duvohuu/Transmission_System_Project/Latex/main.tex

\documentclass[12pt,a4paper]{report}
\input{library}
\addbibresource{references.bib} 

%Header
\fancyhead{} % clear all header fields
\fancyhead[L]{
 \begin{tabular}{rl}
    \begin{picture}(25,15)(0,0)
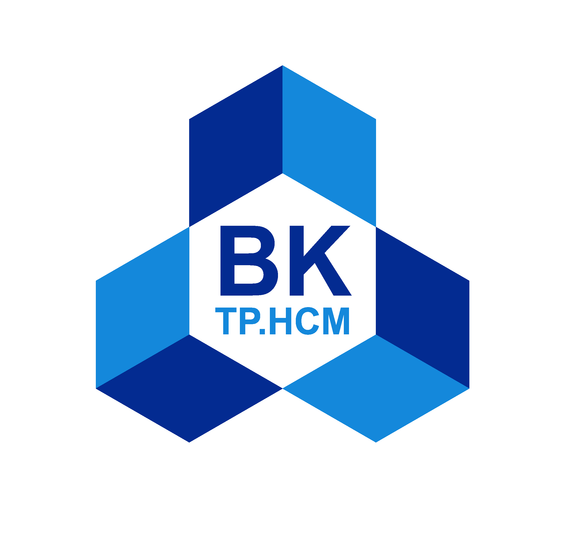
[picture p1: Latex/pictures/hcmut.png]
    \put(0,-8){}
    %\put(0,-8){\epsfig{width=10mm,figure=hcmut.eps}}
   \end{picture}&
	%\includegraphics[width=8mm, height=8mm]{hcmut.png} & %
	\begin{tabular}{l}
		\textbf{\bf \ttfamily Trường Đại Học Bách Khoa - ĐHQG TP.Hồ Chí Minh}\\
		\textbf{\bf \ttfamily Khoa Cơ Khí}\\
	\end{tabular} 	
 \end{tabular}
}
\fancyhead[R]{
	{\tiny \bf \quad} % Khoảng trắng nhỏ trong header bên phải
}

%Footer
\fancyfoot{} % clear all footer fields
\fancyfoot[L]{\scriptsize \ttfamily Đồ án Hệ thống truyền động}
\fancyfoot[R]{\scriptsize \ttfamily Trang {\thepage}/70}
\renewcommand{\headrulewidth}{0.3pt}
\renewcommand{\footrulewidth}{0.3pt}

\begin{document}
    \include{titlepage}
    \tableofcontents  
    \listoftables
    \listoffigures
    \newpage
    \Huge 
    \begin{center}
        \textbf{ĐỀ BÀI}
    \end{center}
    \normalsize
        \begin{figure}[H]
            \centering
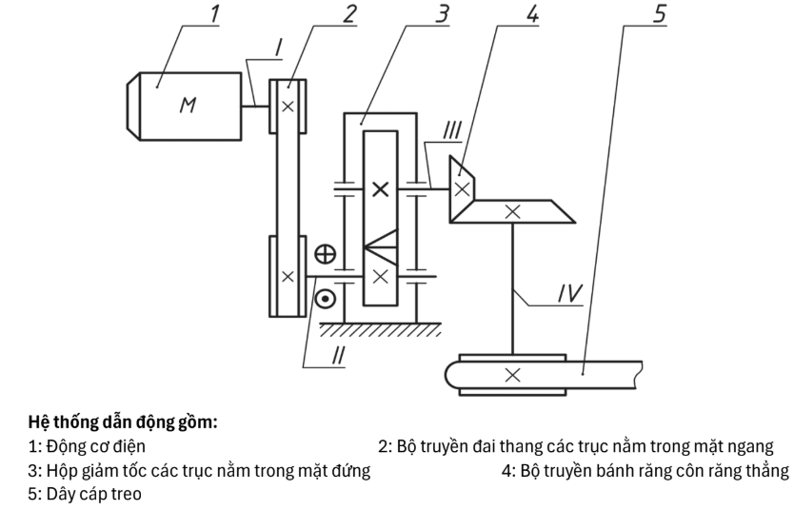
[picture p2: Latex/pictures/topic.png]
            
        \end{figure}
        \begin{center}
            \begin{tabular}{|>{\centering\arraybackslash}m{8cm}|>{\centering\arraybackslash}m{5cm}|}
                \hline
                \textbf{Phương án} & \textbf{2}  \\
                \hline
                Công suất trục cáp, P (kW) & 2.5 \\
                \hline
                Số vòng quay trục cáp, n (vòng/phút) & 12 \\
                \hline
                Thời gian phục vụ, L (năm) & 5 \\
                \hline 
            \end{tabular}\\
            Quay một chiều, làm việc hai ca (1 năm làm việc 300 ngày, 1 ca làm việc 8 giờ)
        \end{center}
        \include{chapter0}
        \include{chapter1}
        \include{chapter2}
        \include{chapter3}
        \include{chapter4}
        \include{chapter5}
        \include{chapter6}
        \include{chapter7}
        \include{chapter8}
        \nocite{*}
        \printbibliography[title={TÀI LIỆU THAM KHẢO}, heading=bibintoc]
\end{document}
