duvohuu/Transmission_System_Project/Latex/titlepage.tex

\begin{titlepage}   
    \begin{center}
        \vspace*{-2cm} 
        \large
        \textbf{ĐẠI HỌC QUỐC GIA THÀNH PHỐ HỒ CHÍ MINH \\
        TRƯỜNG ĐẠI HỌC BÁCH KHOA\\
        KHOA CƠ KHÍ\\}
        \vspace{0.5cm}
         \\
        \rule{\linewidth}{0.5mm}\\
        \vspace{1cm}
        \LARGE
        \textbf{ĐỒ ÁN}\\                                                                                                                                                                                                                    
        \vspace*{0.5cm}
        \Huge
        \textbf{HỆ THỐNG TRUYỀN ĐỘNG}\\                                                                                                                                                                                                                                                                                                                                                                                                                                             
        \vspace{0.5cm}
        \rule{\linewidth}{0.5mm}\\
        \vspace{0.6cm}
        \LARGE
        \textbf{LỚP TN01 - HK 242} \\
        \vspace{0.8cm}
        \large
        \textbf{GVHD: TS. PHẠM MINH TUẤN} \\[0.5cm]
        \vspace{0.5cm}
        SINH VIÊN THỰC HIỆN:\\[0.3cm]
        \begin{tabular}{|>{\centering\arraybackslash}m{1cm}|>{\centering\arraybackslash}m{7cm}|>{\centering\arraybackslash}m{5cm}|}
            \hline
            \textbf{STT} & \textbf{Họ và tên} & \textbf{MSSV} \\
            \hline
            1 & Võ Hữu Dư & 2210604 \\
            \hline
            2 & Võ Trần Trọng Khang & 2211480 \\
            \hline
        \end{tabular}
    \end{center}
        
    \vfill
    \large
    \begin{center}
        TP.HCM, \today
    \end{center}
\end{titlepage}
