duvohuu/Transmission_System_Project/Latex/pictures/elastic_shaft_connection.png

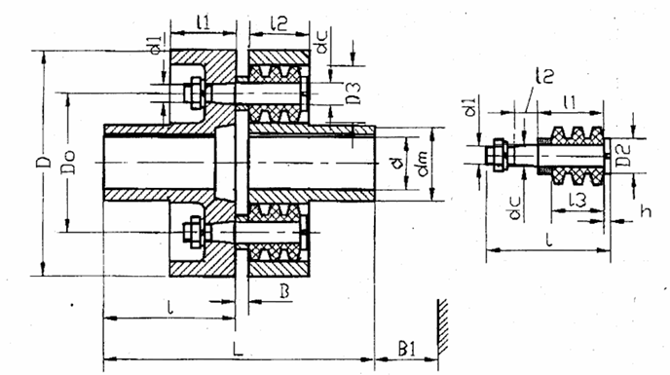
Latex/pictures/elastic_shaft_connection.png
