duvohuu/Transmission_System_Project/Latex/pictures/elastic_shaft_connection_standard.png

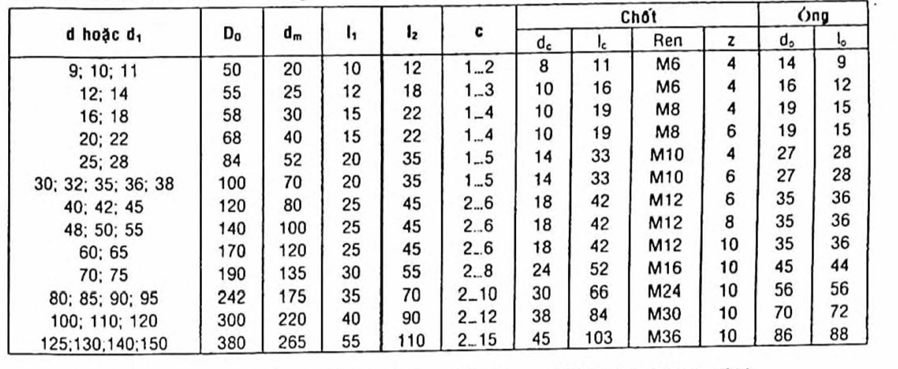
Latex/pictures/elastic_shaft_connection_standard.png
