duvohuu/Transmission_System_Project/Solidworks/10t-winch-1.snapshot.2/Winch.png

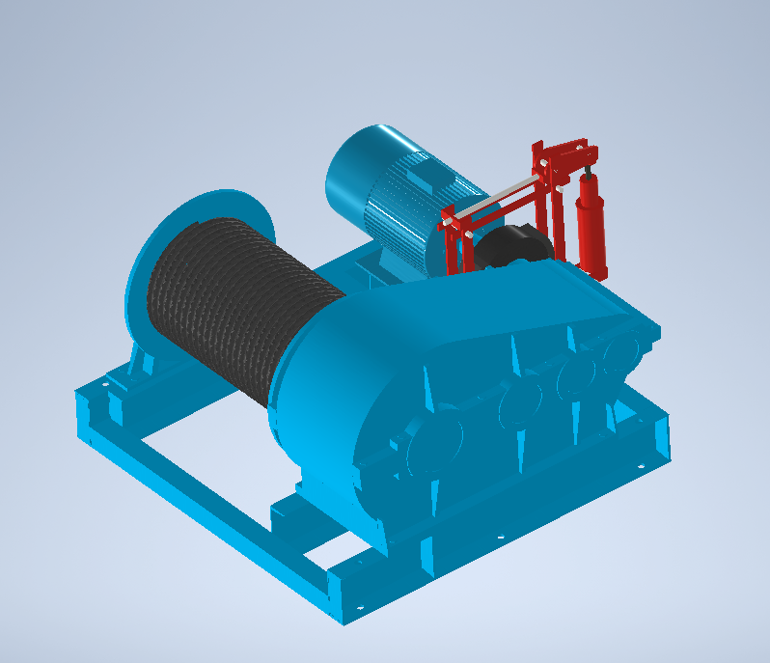
Solidworks/10t-winch-1.snapshot.2/Winch.png
