duvohuu/Transmission_System_Project/Solidworks/weg-electric-motor-132s-1.snapshot.1/Motor11.JPG

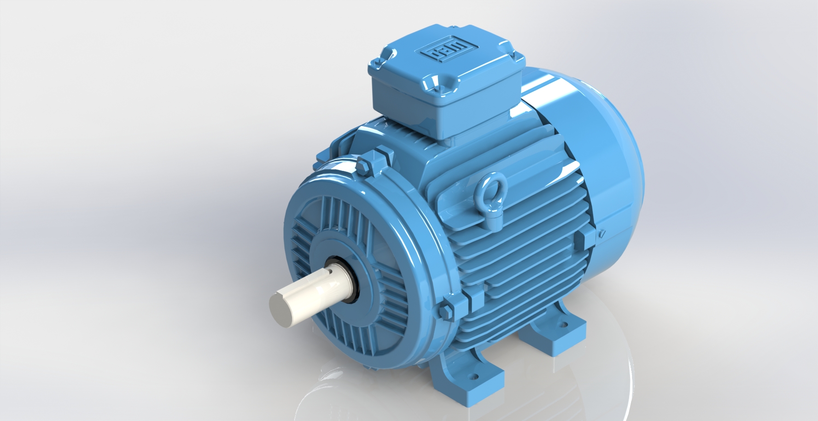
Solidworks/weg-electric-motor-132s-1.snapshot.1/Motor11.JPG
