duvohuu/Transmission_System_Project/Solidworks/10t-winch-1.snapshot.2/卷扬机三维建模.stp

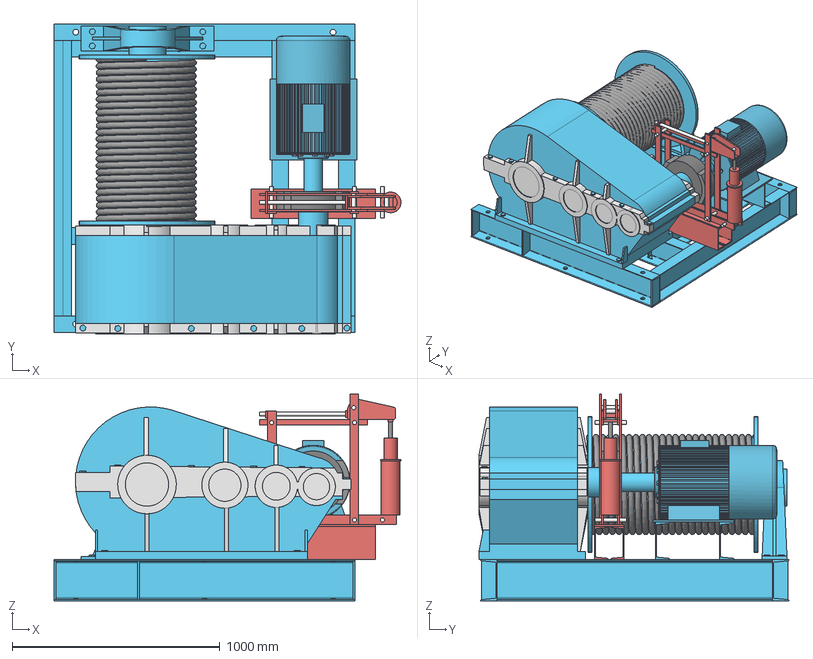
[picture p31: CAD file, 2025-05-07]
Solidworks/10t-winch-1.snapshot.2/卷扬机三维建模.stp
1672.3 x 1495.0 x 997.5 mm
卷扬机三维建模_1
卷扬机三维建模_1_1
卷扬机三维建模_2
卷扬机三维建模_3
卷扬机三维建模_4
卷扬机三维建模_5
卷扬机三维建模_6
卷扬机三维建模_7
卷扬机三维建模_8
卷扬机三维建模_9
卷扬机三维建模_10
卷扬机三维建模_11
卷扬机三维建模_12
卷扬机三维建模_13
卷扬机三维建模_14
卷扬机三维建模_15
卷扬机三维建模_16
卷扬机三维建模_17
卷扬机三维建模_18
卷扬机三维建模_19
卷扬机三维建模_20
卷扬机三维建模_21
卷扬机三维建模_22
卷扬机三维建模_23
卷扬机三维建模_24
卷扬机三维建模_25
卷扬机三维建模_26
卷扬机三维建模_27
卷扬机三维建模_28
卷扬机三维建模_29
卷扬机三维建模_30
卷扬机三维建模_31
卷扬机三维建模_32
卷扬机三维建模_33
卷扬机三维建模_34
卷扬机三维建模_35
卷扬机三维建模_36
卷扬机三维建模_37
卷扬机三维建模_38
卷扬机三维建模_39
卷扬机三维建模_40
卷扬机三维建模_41
卷扬机三维建模_42
卷扬机三维建模_43
卷扬机三维建模_44
卷扬机三维建模_45
卷扬机三维建模_46
卷扬机三维建模_47
卷扬机三维建模_48
卷扬机三维建模_49
卷扬机三维建模_50
卷扬机三维建模_51
卷扬机三维建模_52
卷扬机三维建模_53
卷扬机三维建模_54
卷扬机三维建模_55
卷扬机三维建模_56
卷扬机三维建模_57
卷扬机三维建模_58
卷扬机三维建模_59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
