duvohuu/Transmission_System_Project/Solidworks/helical-gear-box-5.snapshot.1/Helical Gearbox/11.5 Key 100x12 D12.SLDPRT

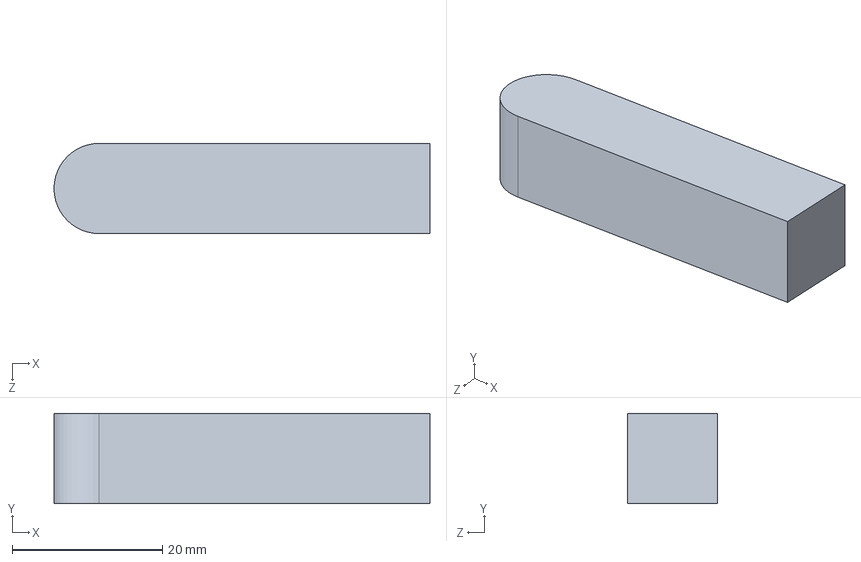
[picture p32: CAD file, 2025-05-07]
Solidworks/helical-gear-box-5.snapshot.1/Helical Gearbox/11.5 Key 100x12 D12.SLDPRT
50.0 x 12.0 x 12.0 mm
