duvohuu/Transmission_System_Project/Solidworks/helical-gear-box-5.snapshot.1/Helical Gearbox/14. Oil Probe.SLDPRT

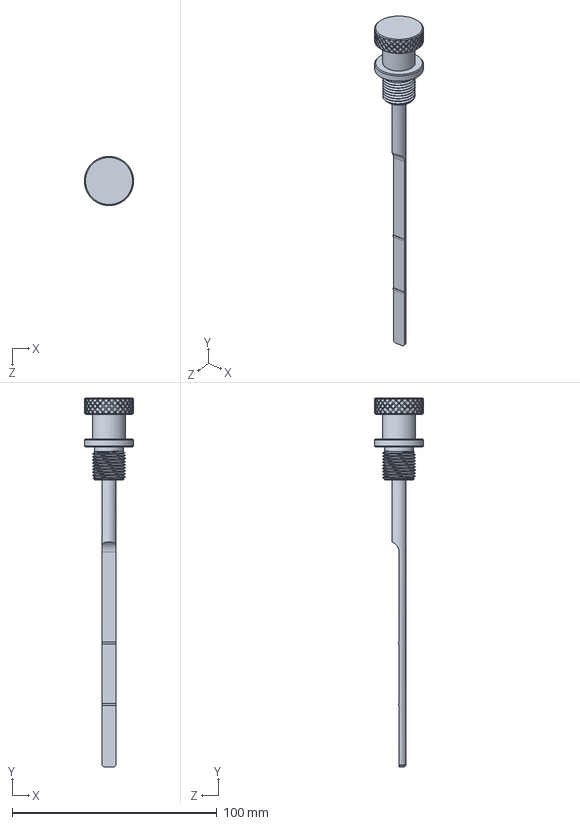
[picture p33: CAD file, 2025-05-07]
Solidworks/helical-gear-box-5.snapshot.1/Helical Gearbox/14. Oil Probe.SLDPRT
24.0 x 180.0 x 24.0 mm
