duvohuu/Transmission_System_Project/Solidworks/helical-gear-box-5.snapshot.1/Helical Gearbox/08. Ring Distance 60x25.5.SLDPRT

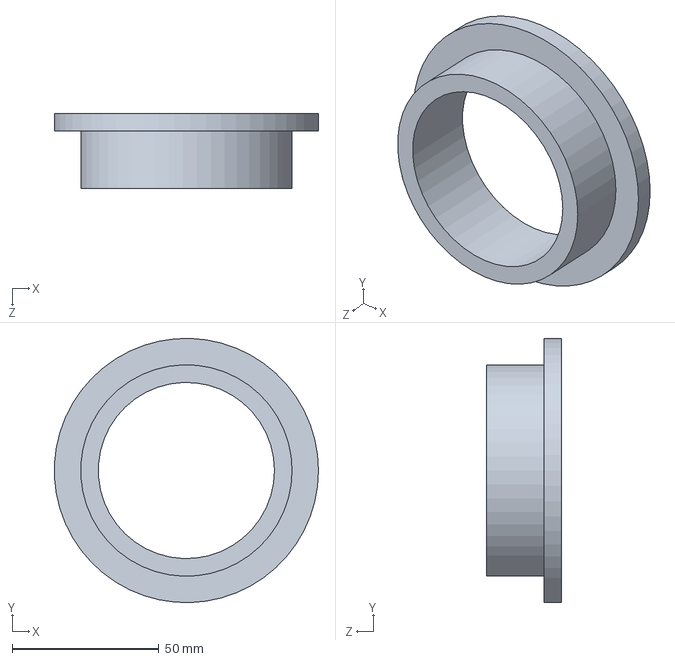
[picture p34: CAD file, 2025-05-07]
Solidworks/helical-gear-box-5.snapshot.1/Helical Gearbox/08. Ring Distance 60x25.5.SLDPRT
89.9 x 90.0 x 25.5 mm
