duvohuu/Transmission_System_Project/Solidworks/helical-gear-box-5.snapshot.1/Helical Gearbox/Gear 21.SLDPRT

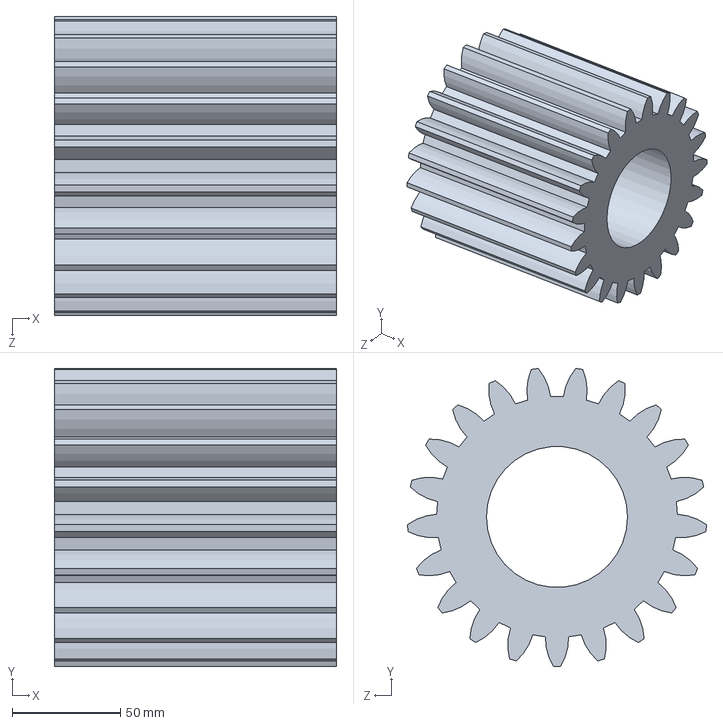
[picture p35: CAD file, 2025-05-07]
Solidworks/helical-gear-box-5.snapshot.1/Helical Gearbox/Gear 21.SLDPRT
130.0 x 137.4 x 137.8 mm
