duvohuu/Transmission_System_Project/Solidworks/helical-gear-box-5.snapshot.1/Helical Gearbox/11.3 Key 115x16 D18.SLDPRT

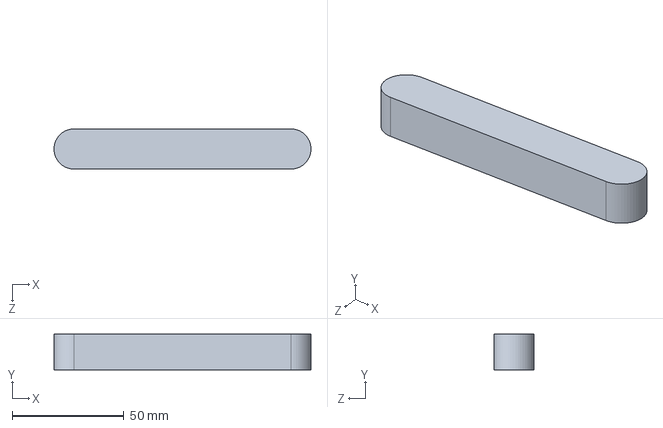
[picture p36: CAD file, 2025-05-07]
Solidworks/helical-gear-box-5.snapshot.1/Helical Gearbox/11.3 Key 115x16 D18.SLDPRT
115.0 x 16.0 x 18.0 mm
