duvohuu/Transmission_System_Project/Solidworks/helical-gear-box-5.snapshot.1/Helical Gearbox/11.1 Key 70x12 D16.SLDPRT

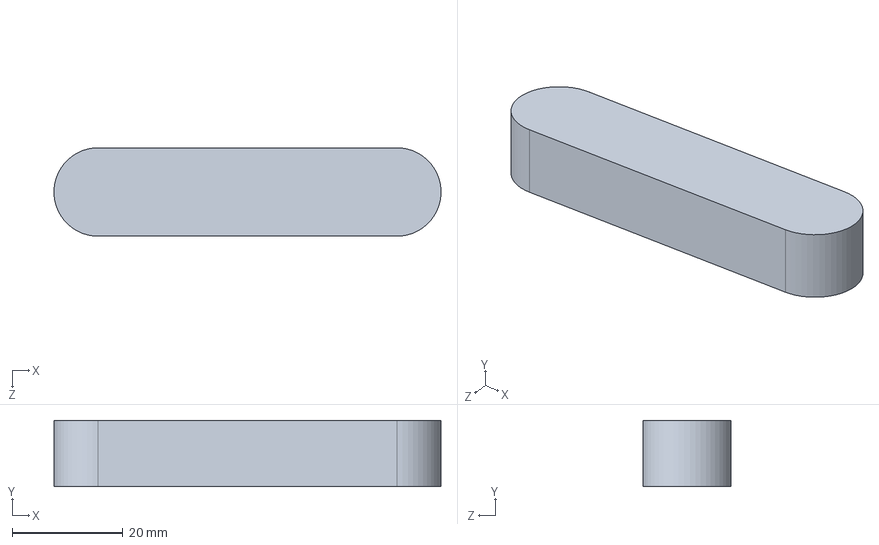
[picture p37: CAD file, 2025-05-07]
Solidworks/helical-gear-box-5.snapshot.1/Helical Gearbox/11.1 Key 70x12 D16.SLDPRT
70.0 x 12.0 x 16.0 mm
