duvohuu/Transmission_System_Project/Solidworks/helical-gear-box-5.snapshot.1/Helical Gearbox/11.2 Key 125x12 D12.SLDPRT

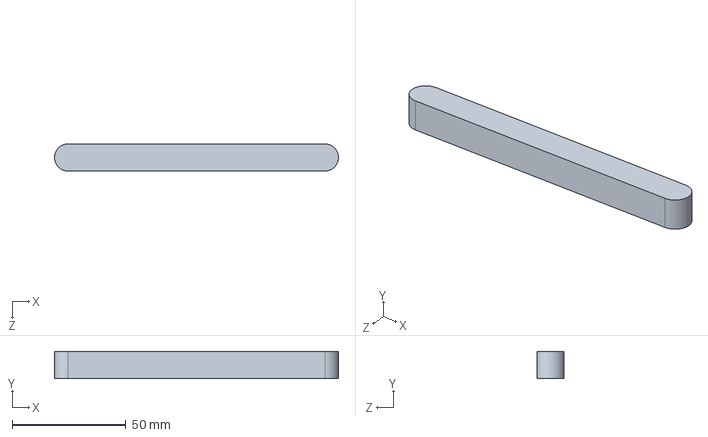
[picture p38: CAD file, 2025-05-07]
Solidworks/helical-gear-box-5.snapshot.1/Helical Gearbox/11.2 Key 125x12 D12.SLDPRT
125.0 x 12.0 x 12.0 mm
