duvohuu/Transmission_System_Project/Solidworks/helical-gear-box-5.snapshot.1/Helical Gearbox/12.Door Cover Plate.SLDPRT

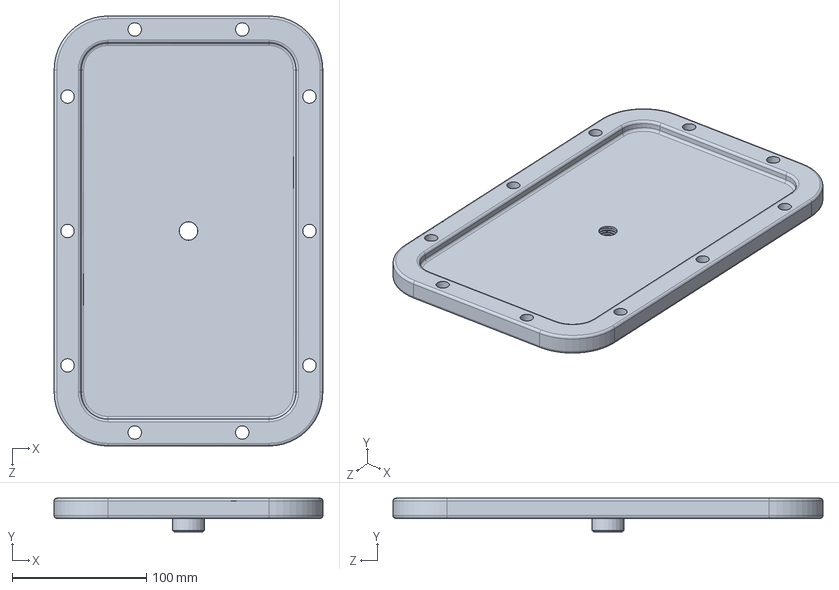
[picture p39: CAD file, 2025-05-07]
Solidworks/helical-gear-box-5.snapshot.1/Helical Gearbox/12.Door Cover Plate.SLDPRT
200.0 x 25.0 x 320.0 mm
