duvohuu/Transmission_System_Project/Solidworks/helical-gear-box-5.snapshot.1/Helical Gearbox/07. Shaft Middle.SLDPRT

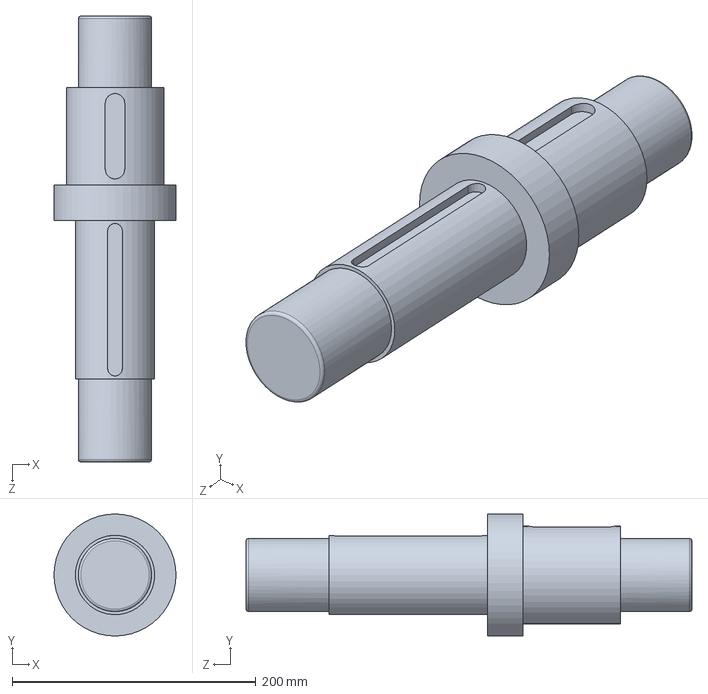
[picture p40: CAD file, 2025-05-07]
Solidworks/helical-gear-box-5.snapshot.1/Helical Gearbox/07. Shaft Middle.SLDPRT
100.0 x 100.0 x 365.5 mm
