duvohuu/Transmission_System_Project/Solidworks/helical-gear-box-5.snapshot.1/Helical Gearbox/10. Ring Distance 85x137.5.SLDPRT

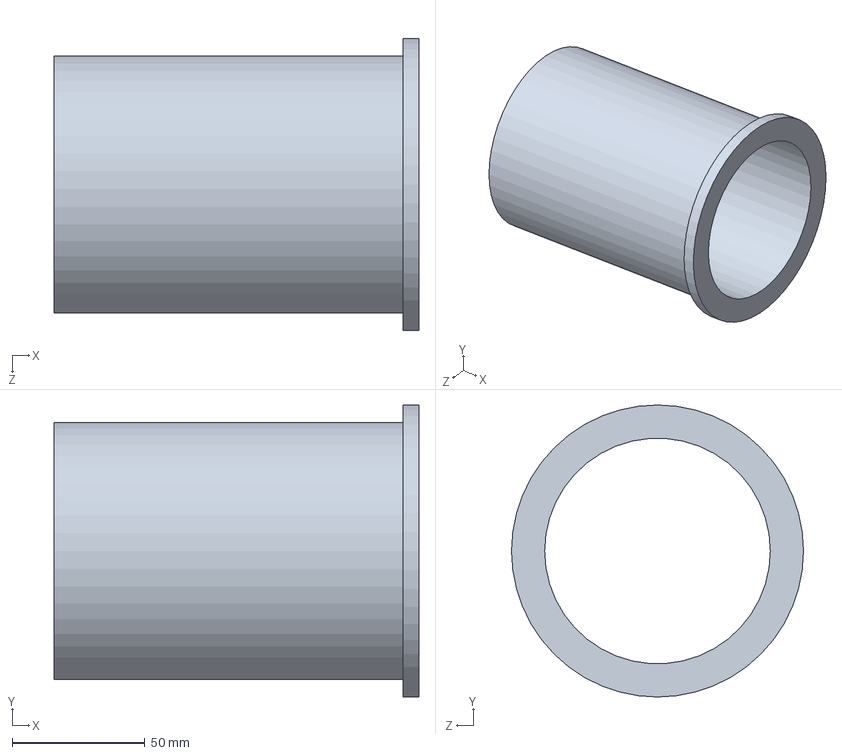
[picture p41: CAD file, 2025-05-07]
Solidworks/helical-gear-box-5.snapshot.1/Helical Gearbox/10. Ring Distance 85x137.5.SLDPRT
137.5 x 110.0 x 110.0 mm
