duvohuu/Transmission_System_Project/Solidworks/helical-gear-box-5.snapshot.1/Helical Gearbox/16. Cover Plate Bearing.SLDPRT

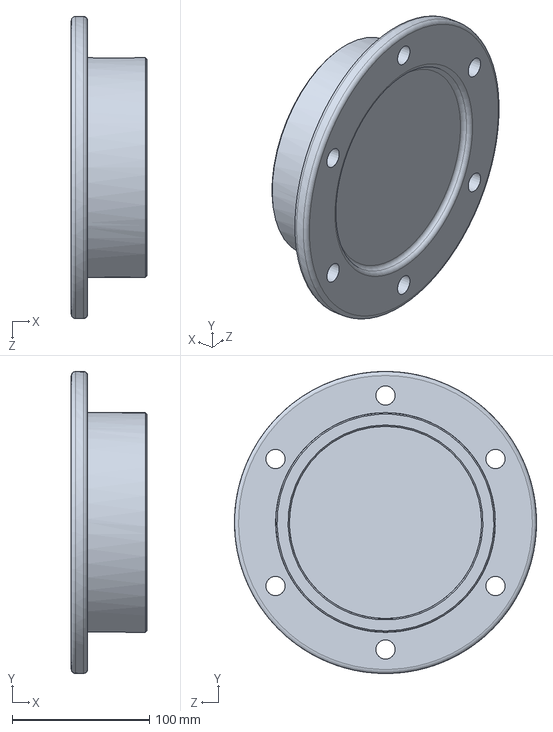
[picture p42: CAD file, 2025-05-07]
Solidworks/helical-gear-box-5.snapshot.1/Helical Gearbox/16. Cover Plate Bearing.SLDPRT
55.0 x 220.0 x 220.0 mm
