duvohuu/Transmission_System_Project/Solidworks/helical-gear-box-5.snapshot.1/Helical Gearbox/13. Blunking Plug.SLDPRT

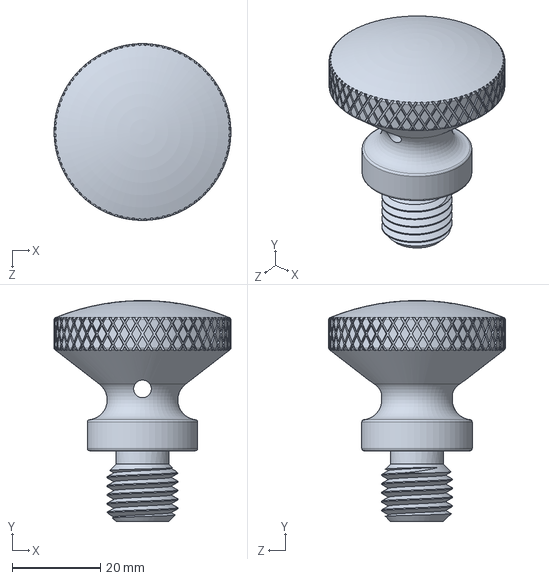
[picture p43: CAD file, 2025-05-07]
Solidworks/helical-gear-box-5.snapshot.1/Helical Gearbox/13. Blunking Plug.SLDPRT
40.0 x 50.0 x 40.0 mm
