duvohuu/Transmission_System_Project/Solidworks/helical-gear-box-5.snapshot.1/Helical Gearbox/05. Shaft Speed Gear 28.SLDPRT

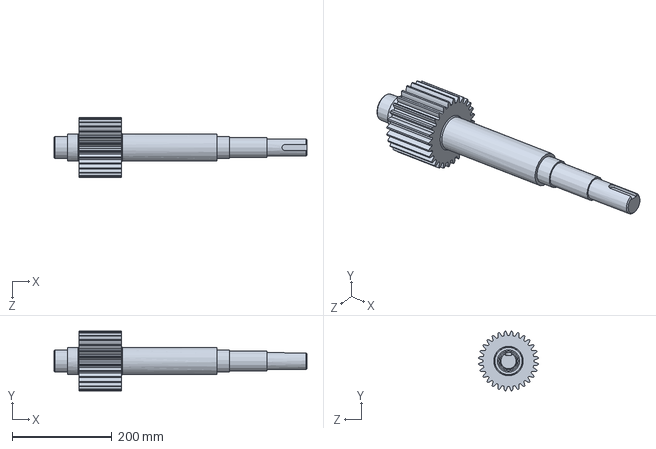
[picture p44: CAD file, 2025-05-07]
Solidworks/helical-gear-box-5.snapshot.1/Helical Gearbox/05. Shaft Speed Gear 28.SLDPRT
507.0 x 119.5 x 119.5 mm
