duvohuu/Transmission_System_Project/Solidworks/helical-gear-box-5.snapshot.1/Helical Gearbox/01. Shell.SLDPRT

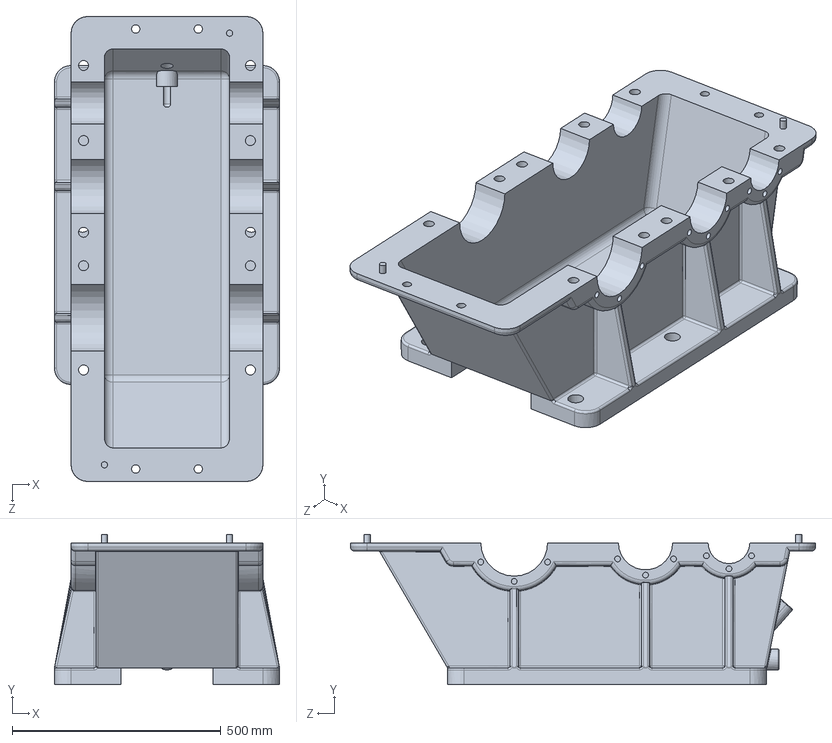
[picture p45: CAD file, 2025-05-07]
Solidworks/helical-gear-box-5.snapshot.1/Helical Gearbox/01. Shell.SLDPRT
540.0 x 360.0 x 1115.0 mm
