duvohuu/Transmission_System_Project/Solidworks/helical-gear-box-5.snapshot.1/Helical Gearbox/09. Ring Distance 60x35.SLDPRT

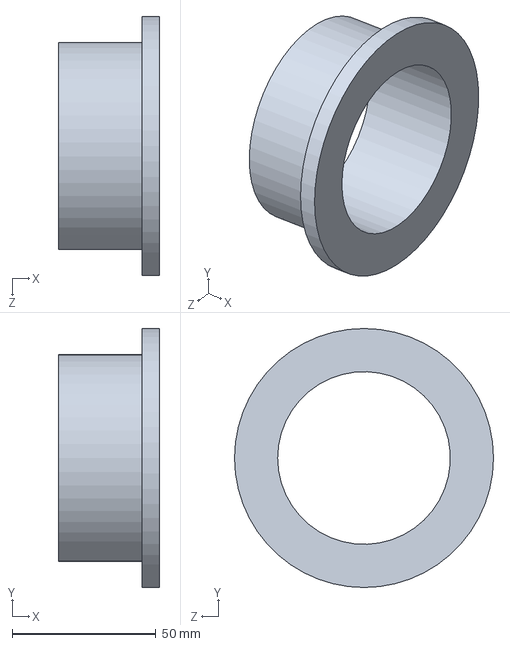
[picture p46: CAD file, 2025-05-07]
Solidworks/helical-gear-box-5.snapshot.1/Helical Gearbox/09. Ring Distance 60x35.SLDPRT
35.0 x 90.0 x 90.0 mm
