duvohuu/Transmission_System_Project/Solidworks/helical-gear-box-5.snapshot.1/Helical Gearbox/04. Gear 84.SLDPRT

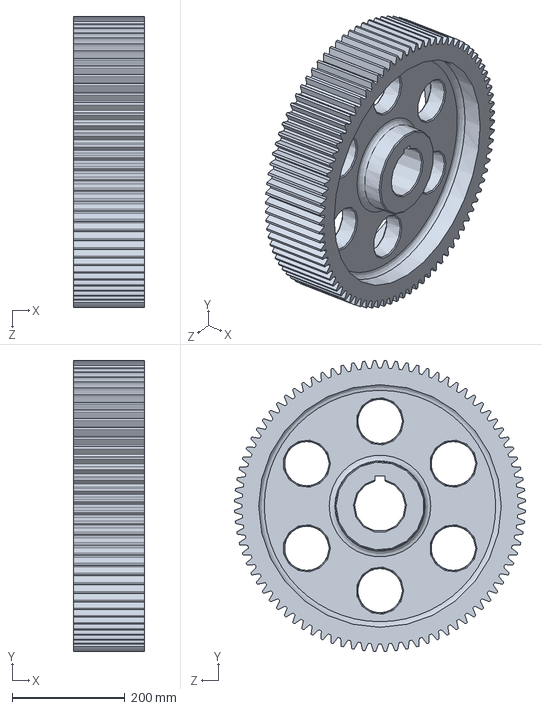
[picture p47: CAD file, 2025-05-07]
Solidworks/helical-gear-box-5.snapshot.1/Helical Gearbox/04. Gear 84.SLDPRT
125.0 x 515.8 x 515.8 mm
