duvohuu/Transmission_System_Project/Solidworks/helical-gear-box-5.snapshot.1/Helical Gearbox/03. Gear 72.SLDPRT

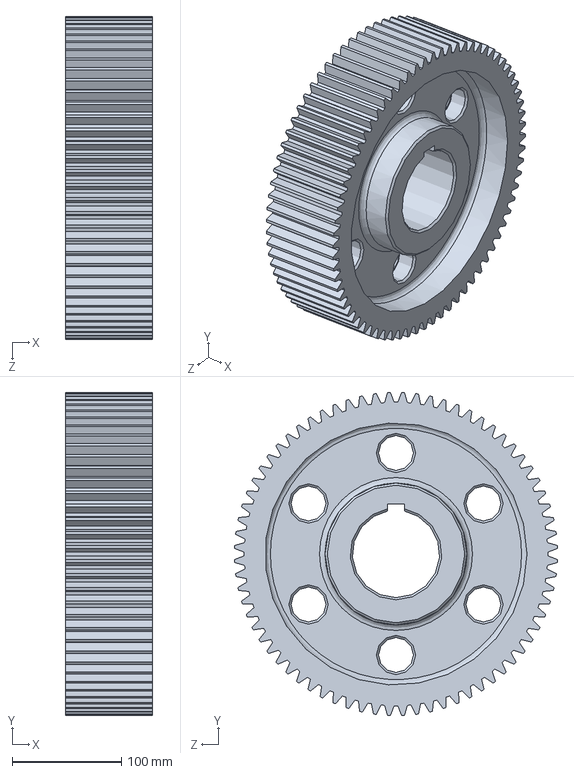
[picture p48: CAD file, 2025-05-07]
Solidworks/helical-gear-box-5.snapshot.1/Helical Gearbox/03. Gear 72.SLDPRT
80.0 x 295.8 x 295.8 mm
