duvohuu/Transmission_System_Project/Solidworks/helical-gear-box-5.snapshot.1/Helical Gearbox/11.4 Key 160x20 D20.SLDPRT

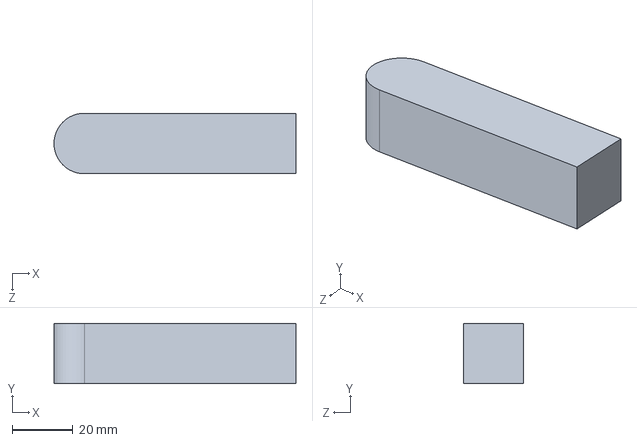
[picture p49: CAD file, 2025-05-07]
Solidworks/helical-gear-box-5.snapshot.1/Helical Gearbox/11.4 Key 160x20 D20.SLDPRT
80.0 x 20.0 x 20.0 mm
