duvohuu/Transmission_System_Project/Solidworks/helical-gear-box-5.snapshot.1/Helical Gearbox/17. Cover Plate Bearing (Hole).SLDPRT

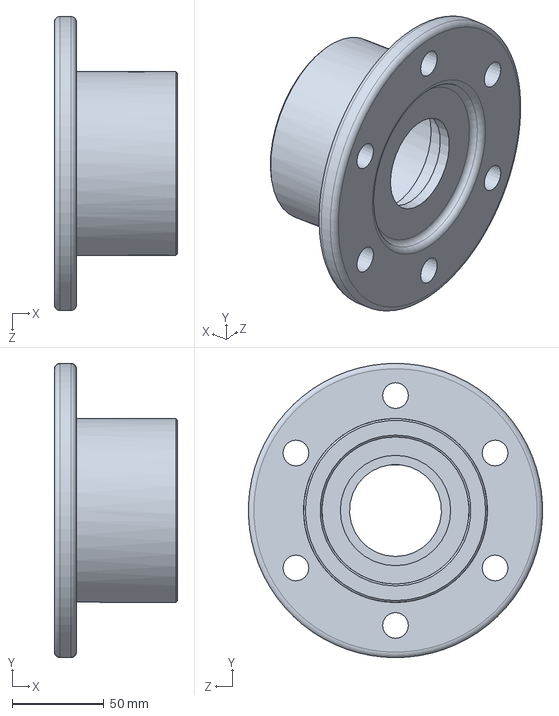
[picture p50: CAD file, 2025-05-07]
Solidworks/helical-gear-box-5.snapshot.1/Helical Gearbox/17. Cover Plate Bearing (Hole).SLDPRT
67.0 x 160.0 x 159.9 mm
