duvohuu/Transmission_System_Project/Solidworks/helical-gear-box-5.snapshot.1/Helical Gearbox/06. Shaft Slow.SLDPRT

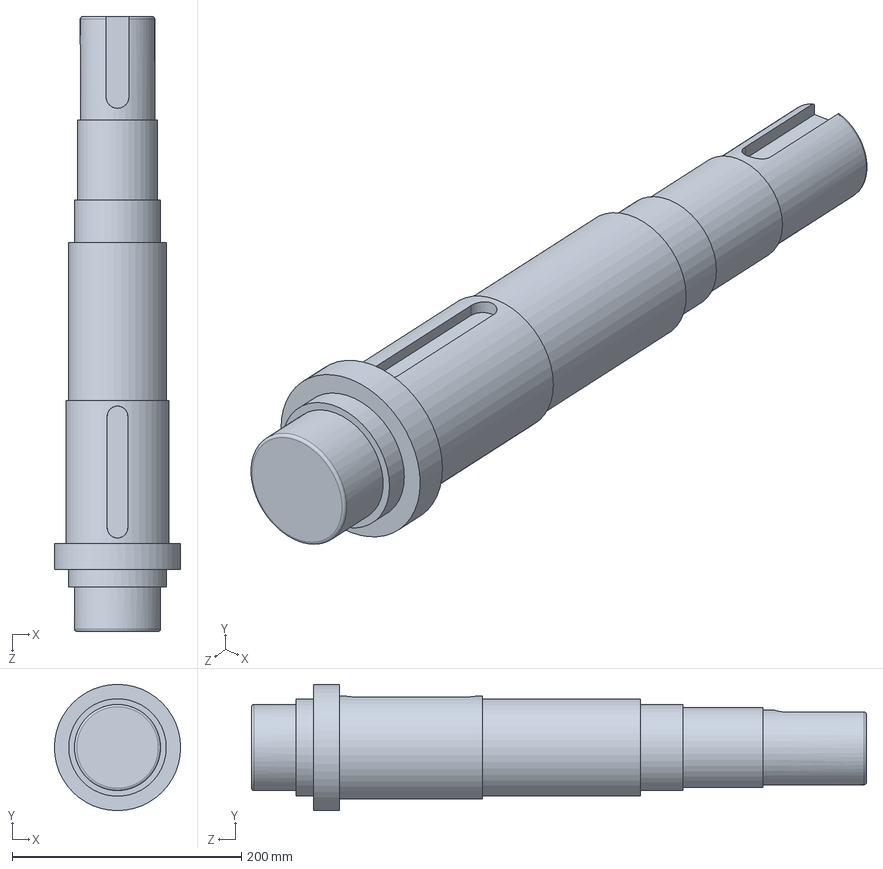
[picture p51: CAD file, 2025-05-07]
Solidworks/helical-gear-box-5.snapshot.1/Helical Gearbox/06. Shaft Slow.SLDPRT
110.0 x 110.0 x 536.0 mm
