duvohuu/Transmission_System_Project/(list of files, cad)

Other CAD files:
Cad/Helical Gearbox Assembly.DWG
Cad/GearBox.dwg
Cad/System.dwg
Cad/Detail_2.dwg
Cad/Detail_1.dwg
Cad/Banhrangcon.dwg
Cad/momen.dwg
Cad/Motor 132S.DWG
Solidworks/10t-winch-1.snapshot.2/10t Winch/--+¿+-+¦+- (4)/Design Data/AIT/Mold Design/mold design stop pin.ipt
Solidworks/10t-winch-1.snapshot.2/10t Winch/--+¿+-+¦+- (4)/Design Data/Cable & Harness/zh-CN/harness.iam
Solidworks/10t-winch-1.snapshot.2/10t Winch/--+¿+-+¦+- (4)/Design Data/Tube & Pipe/zh-CN/piping runs.iam
Solidworks/10t-winch-1.snapshot.2/10t Winch/--+¿+-+¦+- (4)/Workspaces/¦ñ+˜+++S/+f-n+·-ú--/+f-n+·+²+¼+¿-ú.iam
Solidworks/10t-winch-1.snapshot.2/10t Winch/--+¿+-+¦+- (4)/Workspaces/¦ñ+˜+++S/+f-n+·-ú--/+f-n+·+²+¼+¿-ú.ipt
Solidworks/10t-winch-1.snapshot.2/10t Winch/--+¿+-+¦+- (4)/Workspaces/¦ñ+˜+++S/+f-n+·-ú--/+f-n+·+²+¼+¿-ú_1.ipt
Solidworks/10t-winch-1.snapshot.2/10t Winch/--+¿+-+¦+- (4)/Workspaces/¦ñ+˜+++S/+f-n+·-ú--/+f-n+·+²+¼+¿-ú_10.ipt
Solidworks/10t-winch-1.snapshot.2/10t Winch/--+¿+-+¦+- (4)/Workspaces/¦ñ+˜+++S/+f-n+·-ú--/+f-n+·+²+¼+¿-ú_11.ipt
Solidworks/10t-winch-1.snapshot.2/10t Winch/--+¿+-+¦+- (4)/Workspaces/¦ñ+˜+++S/+f-n+·-ú--/+f-n+·+²+¼+¿-ú_12.ipt
Solidworks/10t-winch-1.snapshot.2/10t Winch/--+¿+-+¦+- (4)/Workspaces/¦ñ+˜+++S/+f-n+·-ú--/+f-n+·+²+¼+¿-ú_13.ipt
Solidworks/10t-winch-1.snapshot.2/10t Winch/--+¿+-+¦+- (4)/Workspaces/¦ñ+˜+++S/+f-n+·-ú--/+f-n+·+²+¼+¿-ú_14.ipt
Solidworks/10t-winch-1.snapshot.2/10t Winch/--+¿+-+¦+- (4)/Workspaces/¦ñ+˜+++S/+f-n+·-ú--/+f-n+·+²+¼+¿-ú_15.ipt
Solidworks/10t-winch-1.snapshot.2/10t Winch/--+¿+-+¦+- (4)/Workspaces/¦ñ+˜+++S/+f-n+·-ú--/+f-n+·+²+¼+¿-ú_16.ipt
Solidworks/10t-winch-1.snapshot.2/10t Winch/--+¿+-+¦+- (4)/Workspaces/¦ñ+˜+++S/+f-n+·-ú--/+f-n+·+²+¼+¿-ú_17.ipt
Solidworks/10t-winch-1.snapshot.2/10t Winch/--+¿+-+¦+- (4)/Workspaces/¦ñ+˜+++S/+f-n+·-ú--/+f-n+·+²+¼+¿-ú_18.ipt
Solidworks/10t-winch-1.snapshot.2/10t Winch/--+¿+-+¦+- (4)/Workspaces/¦ñ+˜+++S/+f-n+·-ú--/+f-n+·+²+¼+¿-ú_19.ipt
Solidworks/10t-winch-1.snapshot.2/10t Winch/--+¿+-+¦+- (4)/Workspaces/¦ñ+˜+++S/+f-n+·-ú--/+f-n+·+²+¼+¿-ú_2.ipt
Solidworks/10t-winch-1.snapshot.2/10t Winch/--+¿+-+¦+- (4)/Workspaces/¦ñ+˜+++S/+f-n+·-ú--/+f-n+·+²+¼+¿-ú_20.ipt
Solidworks/10t-winch-1.snapshot.2/10t Winch/--+¿+-+¦+- (4)/Workspaces/¦ñ+˜+++S/+f-n+·-ú--/+f-n+·+²+¼+¿-ú_21.ipt
Solidworks/10t-winch-1.snapshot.2/10t Winch/--+¿+-+¦+- (4)/Workspaces/¦ñ+˜+++S/+f-n+·-ú--/+f-n+·+²+¼+¿-ú_22.ipt
Solidworks/10t-winch-1.snapshot.2/10t Winch/--+¿+-+¦+- (4)/Workspaces/¦ñ+˜+++S/+f-n+·-ú--/+f-n+·+²+¼+¿-ú_23.ipt
Solidworks/10t-winch-1.snapshot.2/10t Winch/--+¿+-+¦+- (4)/Workspaces/¦ñ+˜+++S/+f-n+·-ú--/+f-n+·+²+¼+¿-ú_24.ipt
Solidworks/10t-winch-1.snapshot.2/10t Winch/--+¿+-+¦+- (4)/Workspaces/¦ñ+˜+++S/+f-n+·-ú--/+f-n+·+²+¼+¿-ú_25.ipt
Solidworks/10t-winch-1.snapshot.2/10t Winch/--+¿+-+¦+- (4)/Workspaces/¦ñ+˜+++S/+f-n+·-ú--/+f-n+·+²+¼+¿-ú_26.ipt
Solidworks/10t-winch-1.snapshot.2/10t Winch/--+¿+-+¦+- (4)/Workspaces/¦ñ+˜+++S/+f-n+·-ú--/+f-n+·+²+¼+¿-ú_27.ipt
Solidworks/10t-winch-1.snapshot.2/10t Winch/--+¿+-+¦+- (4)/Workspaces/¦ñ+˜+++S/+f-n+·-ú--/+f-n+·+²+¼+¿-ú_28.ipt
Solidworks/10t-winch-1.snapshot.2/10t Winch/--+¿+-+¦+- (4)/Workspaces/¦ñ+˜+++S/+f-n+·-ú--/+f-n+·+²+¼+¿-ú_29.ipt
Solidworks/10t-winch-1.snapshot.2/10t Winch/--+¿+-+¦+- (4)/Workspaces/¦ñ+˜+++S/+f-n+·-ú--/+f-n+·+²+¼+¿-ú_3.ipt
Solidworks/10t-winch-1.snapshot.2/10t Winch/--+¿+-+¦+- (4)/Workspaces/¦ñ+˜+++S/+f-n+·-ú--/+f-n+·+²+¼+¿-ú_30.ipt
Solidworks/10t-winch-1.snapshot.2/10t Winch/--+¿+-+¦+- (4)/Workspaces/¦ñ+˜+++S/+f-n+·-ú--/+f-n+·+²+¼+¿-ú_31.ipt
Solidworks/10t-winch-1.snapshot.2/10t Winch/--+¿+-+¦+- (4)/Workspaces/¦ñ+˜+++S/+f-n+·-ú--/+f-n+·+²+¼+¿-ú_32.ipt
Solidworks/10t-winch-1.snapshot.2/10t Winch/--+¿+-+¦+- (4)/Workspaces/¦ñ+˜+++S/+f-n+·-ú--/+f-n+·+²+¼+¿-ú_33.ipt
Solidworks/10t-winch-1.snapshot.2/10t Winch/--+¿+-+¦+- (4)/Workspaces/¦ñ+˜+++S/+f-n+·-ú--/+f-n+·+²+¼+¿-ú_34.ipt
Solidworks/10t-winch-1.snapshot.2/10t Winch/--+¿+-+¦+- (4)/Workspaces/¦ñ+˜+++S/+f-n+·-ú--/+f-n+·+²+¼+¿-ú_35.ipt
Solidworks/10t-winch-1.snapshot.2/10t Winch/--+¿+-+¦+- (4)/Workspaces/¦ñ+˜+++S/+f-n+·-ú--/+f-n+·+²+¼+¿-ú_36.ipt
Solidworks/10t-winch-1.snapshot.2/10t Winch/--+¿+-+¦+- (4)/Workspaces/¦ñ+˜+++S/+f-n+·-ú--/+f-n+·+²+¼+¿-ú_37.ipt
Solidworks/10t-winch-1.snapshot.2/10t Winch/--+¿+-+¦+- (4)/Workspaces/¦ñ+˜+++S/+f-n+·-ú--/+f-n+·+²+¼+¿-ú_38.ipt
Solidworks/10t-winch-1.snapshot.2/10t Winch/--+¿+-+¦+- (4)/Workspaces/¦ñ+˜+++S/+f-n+·-ú--/+f-n+·+²+¼+¿-ú_39.ipt
Solidworks/10t-winch-1.snapshot.2/10t Winch/--+¿+-+¦+- (4)/Workspaces/¦ñ+˜+++S/+f-n+·-ú--/+f-n+·+²+¼+¿-ú_4.ipt
Solidworks/10t-winch-1.snapshot.2/10t Winch/--+¿+-+¦+- (4)/Workspaces/¦ñ+˜+++S/+f-n+·-ú--/+f-n+·+²+¼+¿-ú_40.ipt
Solidworks/10t-winch-1.snapshot.2/10t Winch/--+¿+-+¦+- (4)/Workspaces/¦ñ+˜+++S/+f-n+·-ú--/+f-n+·+²+¼+¿-ú_41.ipt
Solidworks/10t-winch-1.snapshot.2/10t Winch/--+¿+-+¦+- (4)/Workspaces/¦ñ+˜+++S/+f-n+·-ú--/+f-n+·+²+¼+¿-ú_42.ipt
Solidworks/10t-winch-1.snapshot.2/10t Winch/--+¿+-+¦+- (4)/Workspaces/¦ñ+˜+++S/+f-n+·-ú--/+f-n+·+²+¼+¿-ú_43.ipt
Solidworks/10t-winch-1.snapshot.2/10t Winch/--+¿+-+¦+- (4)/Workspaces/¦ñ+˜+++S/+f-n+·-ú--/+f-n+·+²+¼+¿-ú_44.ipt
Solidworks/10t-winch-1.snapshot.2/10t Winch/--+¿+-+¦+- (4)/Workspaces/¦ñ+˜+++S/+f-n+·-ú--/+f-n+·+²+¼+¿-ú_45.ipt
Solidworks/10t-winch-1.snapshot.2/10t Winch/--+¿+-+¦+- (4)/Workspaces/¦ñ+˜+++S/+f-n+·-ú--/+f-n+·+²+¼+¿-ú_46.ipt
Solidworks/10t-winch-1.snapshot.2/10t Winch/--+¿+-+¦+- (4)/Workspaces/¦ñ+˜+++S/+f-n+·-ú--/+f-n+·+²+¼+¿-ú_47.ipt
Solidworks/10t-winch-1.snapshot.2/10t Winch/--+¿+-+¦+- (4)/Workspaces/¦ñ+˜+++S/+f-n+·-ú--/+f-n+·+²+¼+¿-ú_48.ipt
Solidworks/10t-winch-1.snapshot.2/10t Winch/--+¿+-+¦+- (4)/Workspaces/¦ñ+˜+++S/+f-n+·-ú--/+f-n+·+²+¼+¿-ú_49.ipt
Solidworks/10t-winch-1.snapshot.2/10t Winch/--+¿+-+¦+- (4)/Workspaces/¦ñ+˜+++S/+f-n+·-ú--/+f-n+·+²+¼+¿-ú_5.ipt
Solidworks/10t-winch-1.snapshot.2/10t Winch/--+¿+-+¦+- (4)/Workspaces/¦ñ+˜+++S/+f-n+·-ú--/+f-n+·+²+¼+¿-ú_50.ipt
Solidworks/10t-winch-1.snapshot.2/10t Winch/--+¿+-+¦+- (4)/Workspaces/¦ñ+˜+++S/+f-n+·-ú--/+f-n+·+²+¼+¿-ú_51.ipt
Solidworks/10t-winch-1.snapshot.2/10t Winch/--+¿+-+¦+- (4)/Workspaces/¦ñ+˜+++S/+f-n+·-ú--/+f-n+·+²+¼+¿-ú_52.ipt
Solidworks/10t-winch-1.snapshot.2/10t Winch/--+¿+-+¦+- (4)/Workspaces/¦ñ+˜+++S/+f-n+·-ú--/+f-n+·+²+¼+¿-ú_53.ipt
Solidworks/10t-winch-1.snapshot.2/10t Winch/--+¿+-+¦+- (4)/Workspaces/¦ñ+˜+++S/+f-n+·-ú--/+f-n+·+²+¼+¿-ú_54.ipt
Solidworks/10t-winch-1.snapshot.2/10t Winch/--+¿+-+¦+- (4)/Workspaces/¦ñ+˜+++S/+f-n+·-ú--/+f-n+·+²+¼+¿-ú_55.ipt
Solidworks/10t-winch-1.snapshot.2/10t Winch/--+¿+-+¦+- (4)/Workspaces/¦ñ+˜+++S/+f-n+·-ú--/+f-n+·+²+¼+¿-ú_56.ipt
Solidworks/10t-winch-1.snapshot.2/10t Winch/--+¿+-+¦+- (4)/Workspaces/¦ñ+˜+++S/+f-n+·-ú--/+f-n+·+²+¼+¿-ú_57.ipt
Solidworks/10t-winch-1.snapshot.2/10t Winch/--+¿+-+¦+- (4)/Workspaces/¦ñ+˜+++S/+f-n+·-ú--/+f-n+·+²+¼+¿-ú_58.ipt
Solidworks/10t-winch-1.snapshot.2/10t Winch/--+¿+-+¦+- (4)/Workspaces/¦ñ+˜+++S/+f-n+·-ú--/+f-n+·+²+¼+¿-ú_59.ipt
Solidworks/10t-winch-1.snapshot.2/10t Winch/--+¿+-+¦+- (4)/Workspaces/¦ñ+˜+++S/+f-n+·-ú--/+f-n+·+²+¼+¿-ú_6.ipt
Solidworks/10t-winch-1.snapshot.2/10t Winch/--+¿+-+¦+- (4)/Workspaces/¦ñ+˜+++S/+f-n+·-ú--/+f-n+·+²+¼+¿-ú_60.ipt
Solidworks/10t-winch-1.snapshot.2/10t Winch/--+¿+-+¦+- (4)/Workspaces/¦ñ+˜+++S/+f-n+·-ú--/+f-n+·+²+¼+¿-ú_61.ipt
Solidworks/10t-winch-1.snapshot.2/10t Winch/--+¿+-+¦+- (4)/Workspaces/¦ñ+˜+++S/+f-n+·-ú--/+f-n+·+²+¼+¿-ú_62.ipt
Solidworks/10t-winch-1.snapshot.2/10t Winch/--+¿+-+¦+- (4)/Workspaces/¦ñ+˜+++S/+f-n+·-ú--/+f-n+·+²+¼+¿-ú_63.ipt
Solidworks/10t-winch-1.snapshot.2/10t Winch/--+¿+-+¦+- (4)/Workspaces/¦ñ+˜+++S/+f-n+·-ú--/+f-n+·+²+¼+¿-ú_64.ipt
Solidworks/10t-winch-1.snapshot.2/10t Winch/--+¿+-+¦+- (4)/Workspaces/¦ñ+˜+++S/+f-n+·-ú--/+f-n+·+²+¼+¿-ú_65.ipt
Solidworks/10t-winch-1.snapshot.2/10t Winch/--+¿+-+¦+- (4)/Workspaces/¦ñ+˜+++S/+f-n+·-ú--/+f-n+·+²+¼+¿-ú_66.ipt
Solidworks/10t-winch-1.snapshot.2/10t Winch/--+¿+-+¦+- (4)/Workspaces/¦ñ+˜+++S/+f-n+·-ú--/+f-n+·+²+¼+¿-ú_67.ipt
Solidworks/10t-winch-1.snapshot.2/10t Winch/--+¿+-+¦+- (4)/Workspaces/¦ñ+˜+++S/+f-n+·-ú--/+f-n+·+²+¼+¿-ú_68.ipt
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
