duvohuu/Transmission_System_Project/Solidworks/helical-gear-box-5.snapshot.1/Helical Gearbox/Helical Gearbox Assembly.png

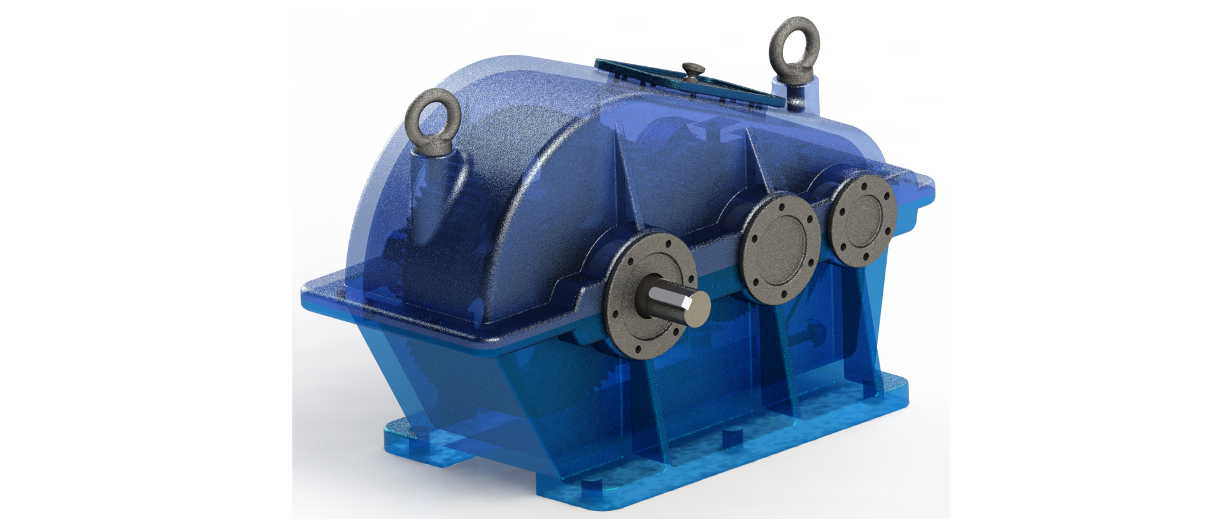
Solidworks/helical-gear-box-5.snapshot.1/Helical Gearbox/Helical Gearbox Assembly.png
