duvohuu/Transmission_System_Project/Drawing/Detail1_Final.pdf

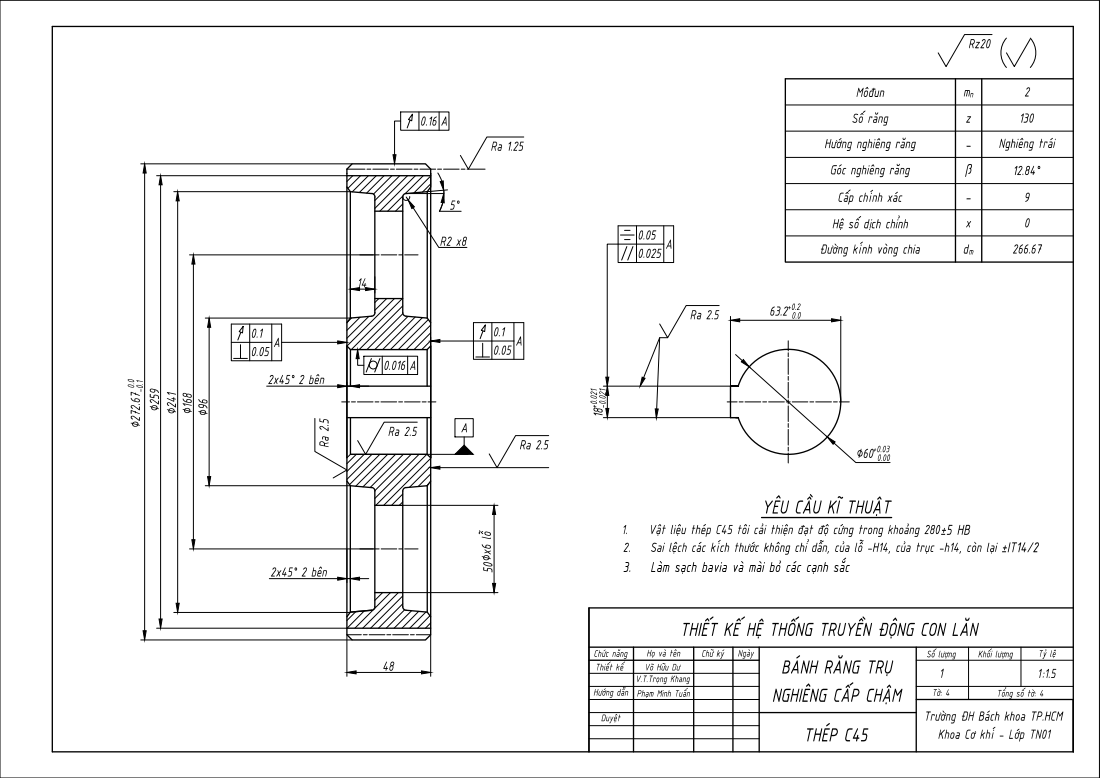
[picture p53: page 1]
Hướng dẫn; Phạm Minh Tuấn; Tổng số tờ: 4; THÉP C45; Cấp chính xác; 2x45° 2 bên 2x45° 2 bên ∅259 ∅241 ∅272.67 0.0 -0.1

Môđun | mn | 2

Số răng | z | 130

Hướng nghiêng răng | -β | Nghiêng trái

Góc nghiêng răng | | 12.84°

Hệ số dịch chỉnh | x | 0

0.05 | A
0.025

Đường kính vòng chia | dm | 266.67

YÊU CẦU KĨ THUẬT

1. Vật liệu thép C45 tôi cải thiện đạt độ cứng trong khoảng 280±5 HB
2. Sai lệch các kích thước không chỉ dẫn, của lỗ -H14, của trục -h14, còn lại ±IT14/2
3. Làm sạch bavia và mài bỏ các cạnh sắc

THIẾT KẾ HỆ THỐNG TRUYỀN ĐỘNG CON LĂN

Chức năng | Họ và tên | Chữ ký | Ngày | BÁNH RĂNG TRỤ NGHIÊNG CẤP CHẬM | Số lượng | Khối lượng | Tỷ lệ
Thiết kế | V.T.Trọng Khang Võ Hữu Dư | | | | 1 | | 1:1.5

Trường ĐH Bách khoa TP.HCM
Khoa Cơ khí - Lớp TN01
