duvohuu/Transmission_System_Project/Drawing/Detail2_Final.pdf

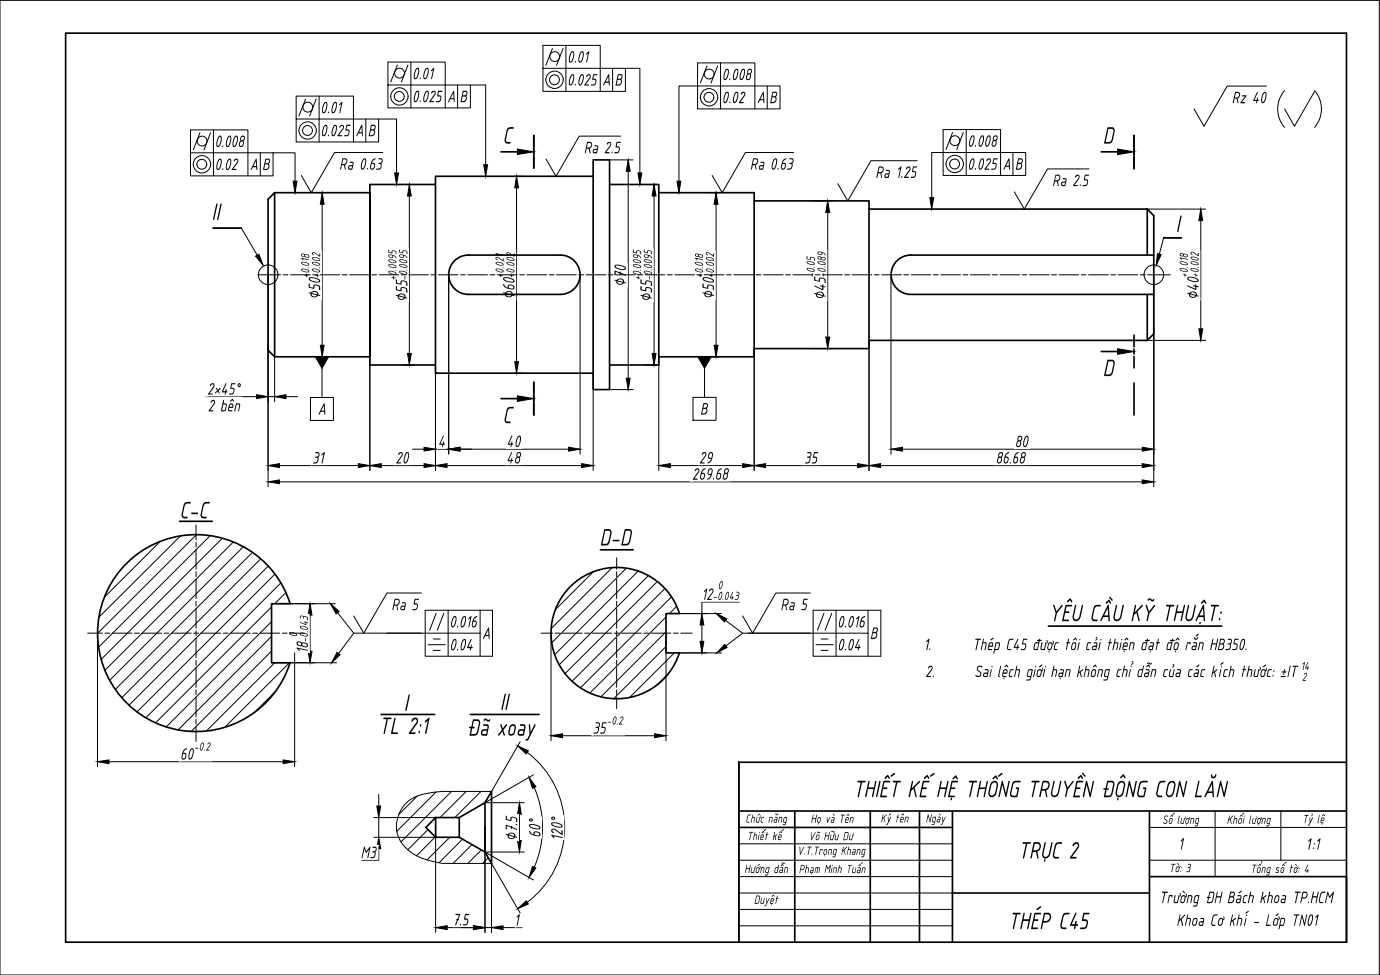
[picture p54: page 1]
2 bên; THÉP C45; Đã xoay

0.01 | A B
0.025

YÊU CẦU KỸ THUẬT:

1. Thép C45 được tôi cải thiện đạt độ rắn HB350.
2. Sai lệch giới hạn không chỉ dẫn của các kích thước: ±IT

THIẾT KẾ HỆ THỐNG TRUYỀN ĐỘNG CON LĂN

Chức năng | Họ và Tên | Ký tên | Ngày | TRỤC 2 | Số lượng | Khối lượng | Tỷ lệ
Thiết kế | Võ Hữu Dư | | | | 1 | | 1:1

V.T.Trọng Khang

Hướng dẫn | Phạm Minh Tuấn | | | | Tờ: 3 | Tổng số tờ: 4

Trường ĐH Bách khoa TP.HCM
Khoa Cơ khí - Lớp TN01
