duvohuu/Transmission_System_Project/Drawing/GearBox_Final.pdf

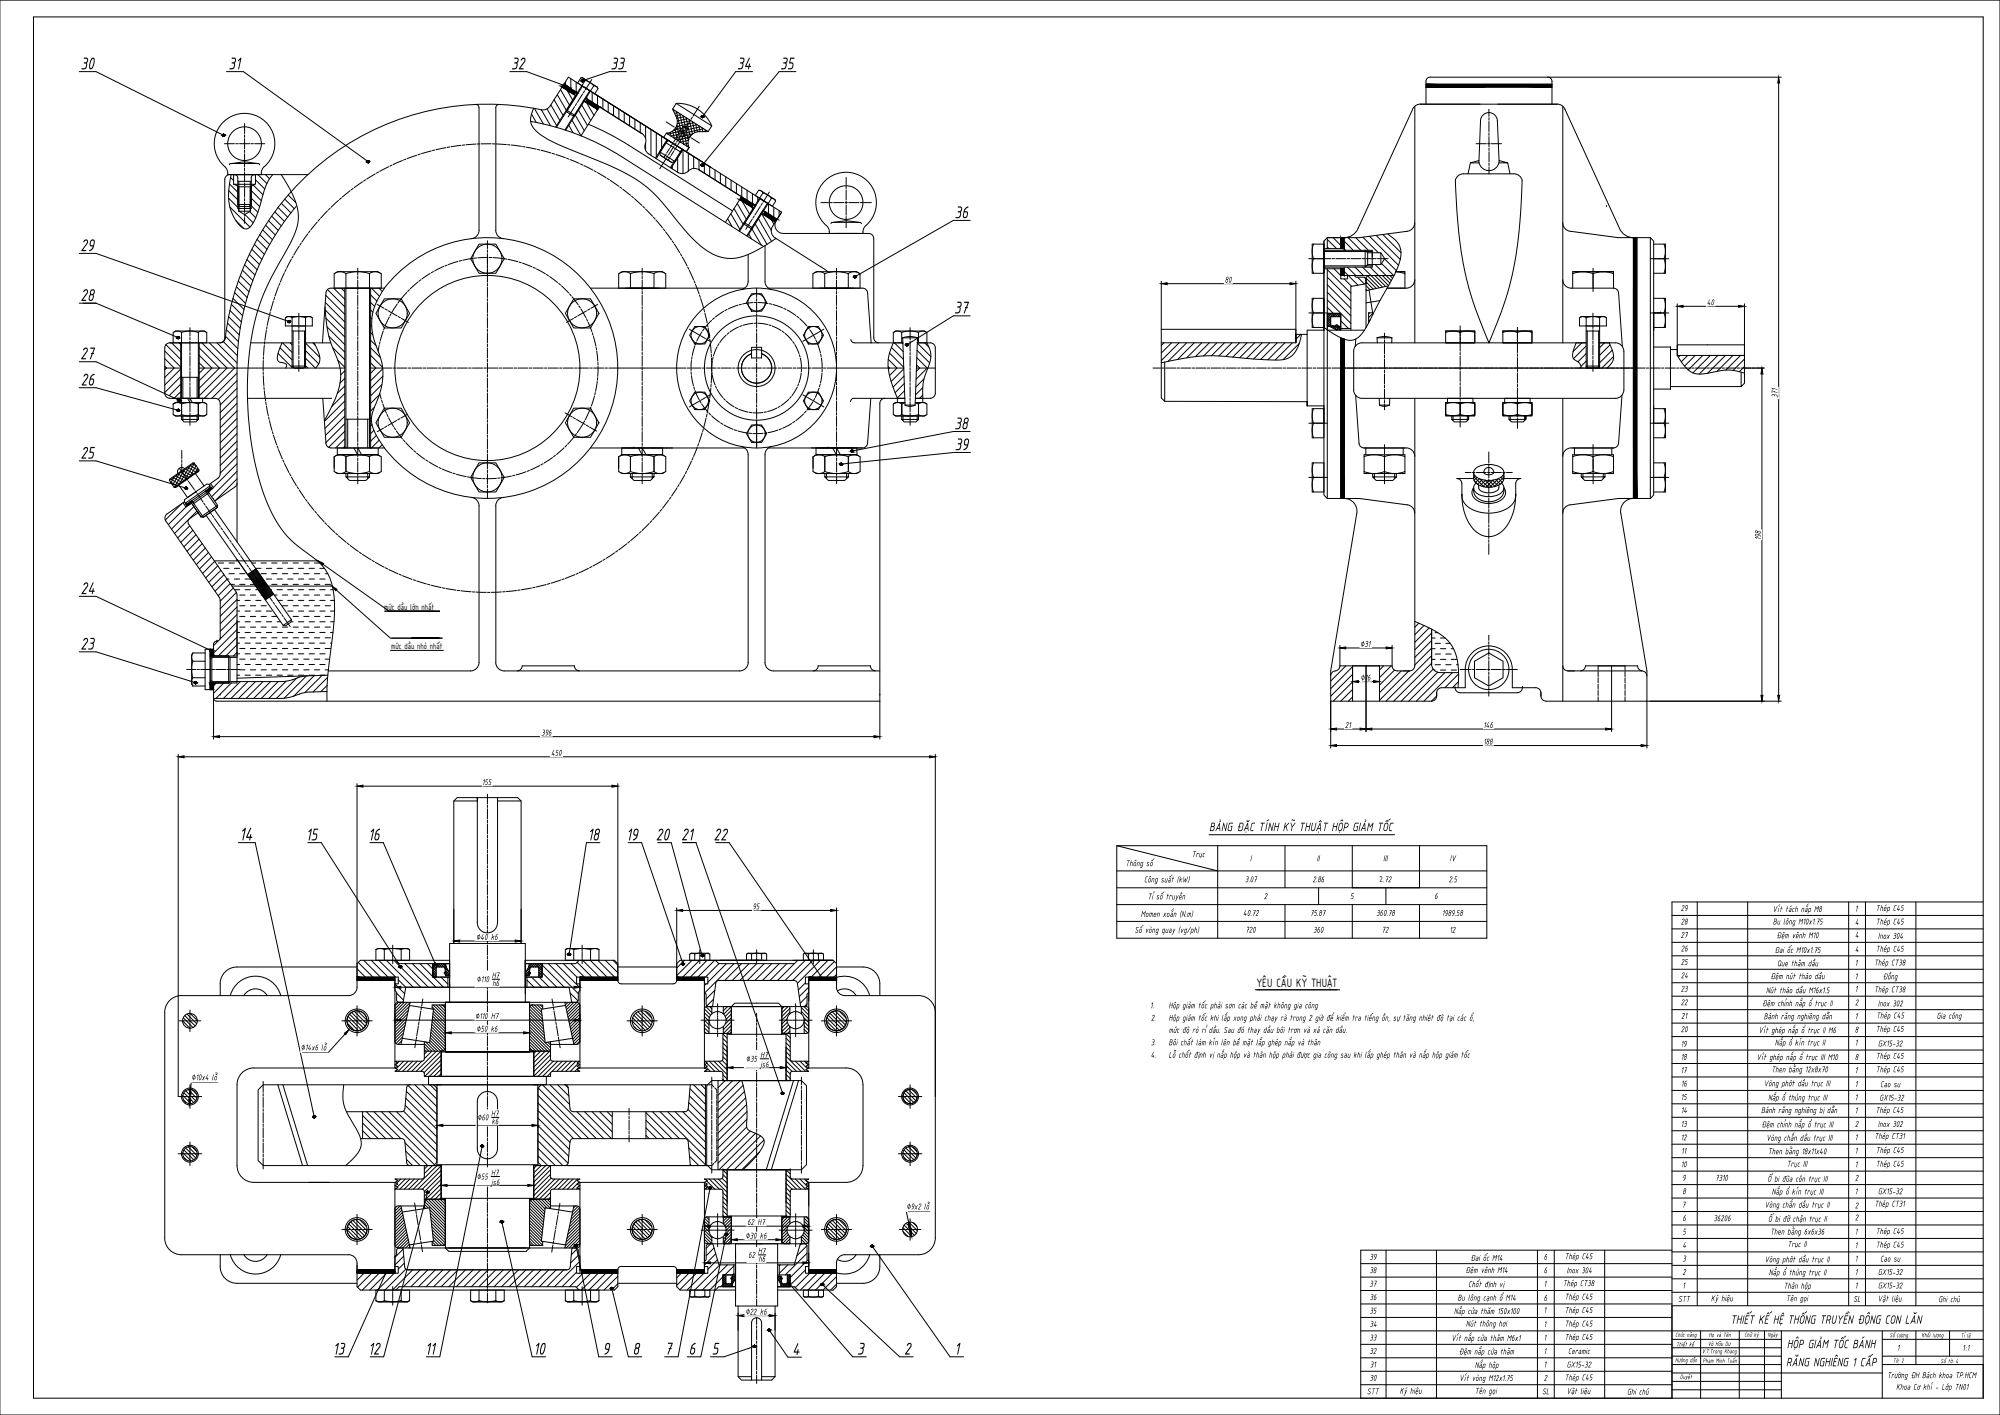
[picture p55: page 1]
STT; Ký hiệu; Tên gọi; Vật liệu; Ghi chú 2315649108121311716152021 1723242226272529281819; HỘP GIẢM TỐC BÁNH; 1:1 RĂNG NGHIÊNG 1 CẤP 14; Trường ĐH Bách khoa TP.HCM; Nắp ổ thủng trục II; GX15-32 GX15-32 Vòng phớt dầu trục II; 8 Trục II; GX15-32 Vòng chắn dầu trục II; Cao su Then bằng 6x6x36; 1 Ổ bi đỡ chặn trục II; Thép C45 Thép C45 Nắp ổ kín trục III; Thép C45 12; Inox 302 1414; Thép CT38 Thép C45 Vòng phớt dầu trục III; 1 Trục III; Thép C45 1; Cao su 8; Đồng 1; Thép C45 4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

198 Trục Thông số I II Công suất (kW)

mức dầu lớn nhất

Tỉ số truyền

THIẾT KẾ HỆ THỐNG TRUYỀN ĐỘNG CON LĂN

Họ và Tên Võ Hữu Dư Phạm Minh Tuấn V.T.Trọng Khang | Chữ ký | Ngày | Số lượng | Khối lượng Số tờ: 4 | Tỉ lệ Tờ: 2

Hướng dẫn

Khoa Cơ khí - Lớp TN01
