duvohuu/Transmission_System_Project/Drawing/System_Final.pdf

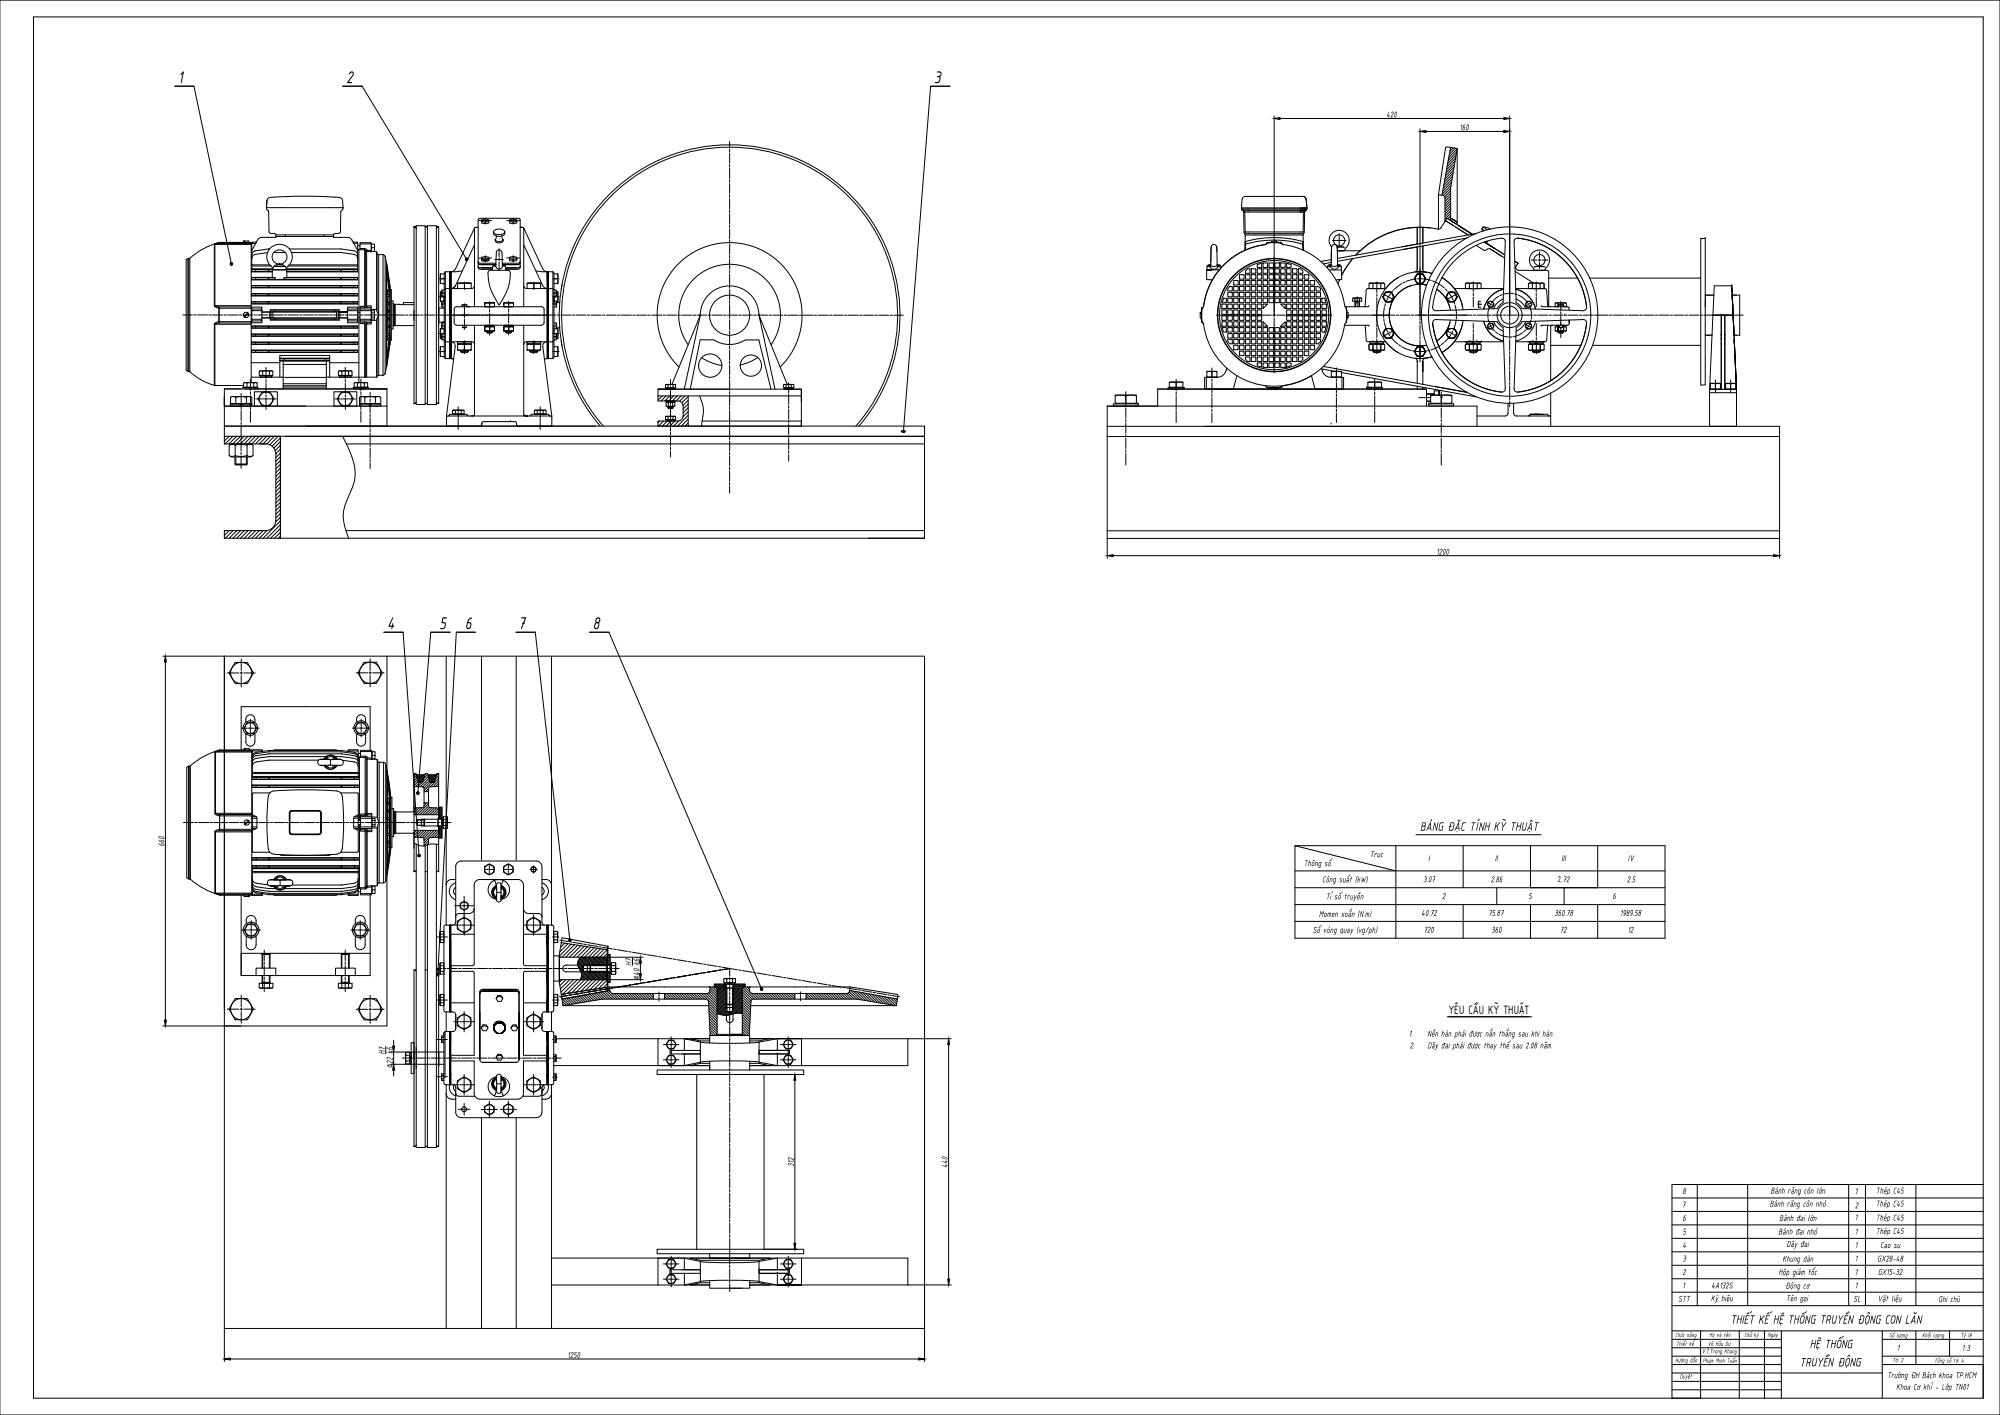
[picture p56: page 1]
Thép C45 4A132S 4 1; Thép C45 1200 1250

k6 3 THIẾT KẾ HỆ THỐNG TRUYỀN ĐỘNG CON LĂN

660 Trục Thông số I II Công suất (kW)

Tỉ số truyền

STT | Ký hiệu | Tên gọi Dây đai | SL | Vật liệu 1 | Ghi chú 23156487 1:3 Chức năng

Bánh răng côn lớn | 211 | Thép C45
Bánh răng côn nhỏ | 1 1 Bánh đai lớn 1 | GX28-48 Bánh đai nhỏ Cao su Thép C45

Hộp giảm tốc | 11 | GX15-32 Khung dàn

Động cơ

Thiết kế | | | | | Số lượng | Khối lượng Tổng số tờ: 4 | Tỷ lệ Tờ: 2

Họ và tên | Chữ ký | Ngày | HỆ THỐNG TRUYỀN ĐỘNG
Phạm Minh Tuấn Võ Hữu Dư V.T.Trọng Khang

Hướng dẫn

Trường ĐH Bách khoa TP.HCM
Khoa Cơ khí - Lớp TN01
