duvohuu/Transmission_System_Project/Drawing/System_3.pdf

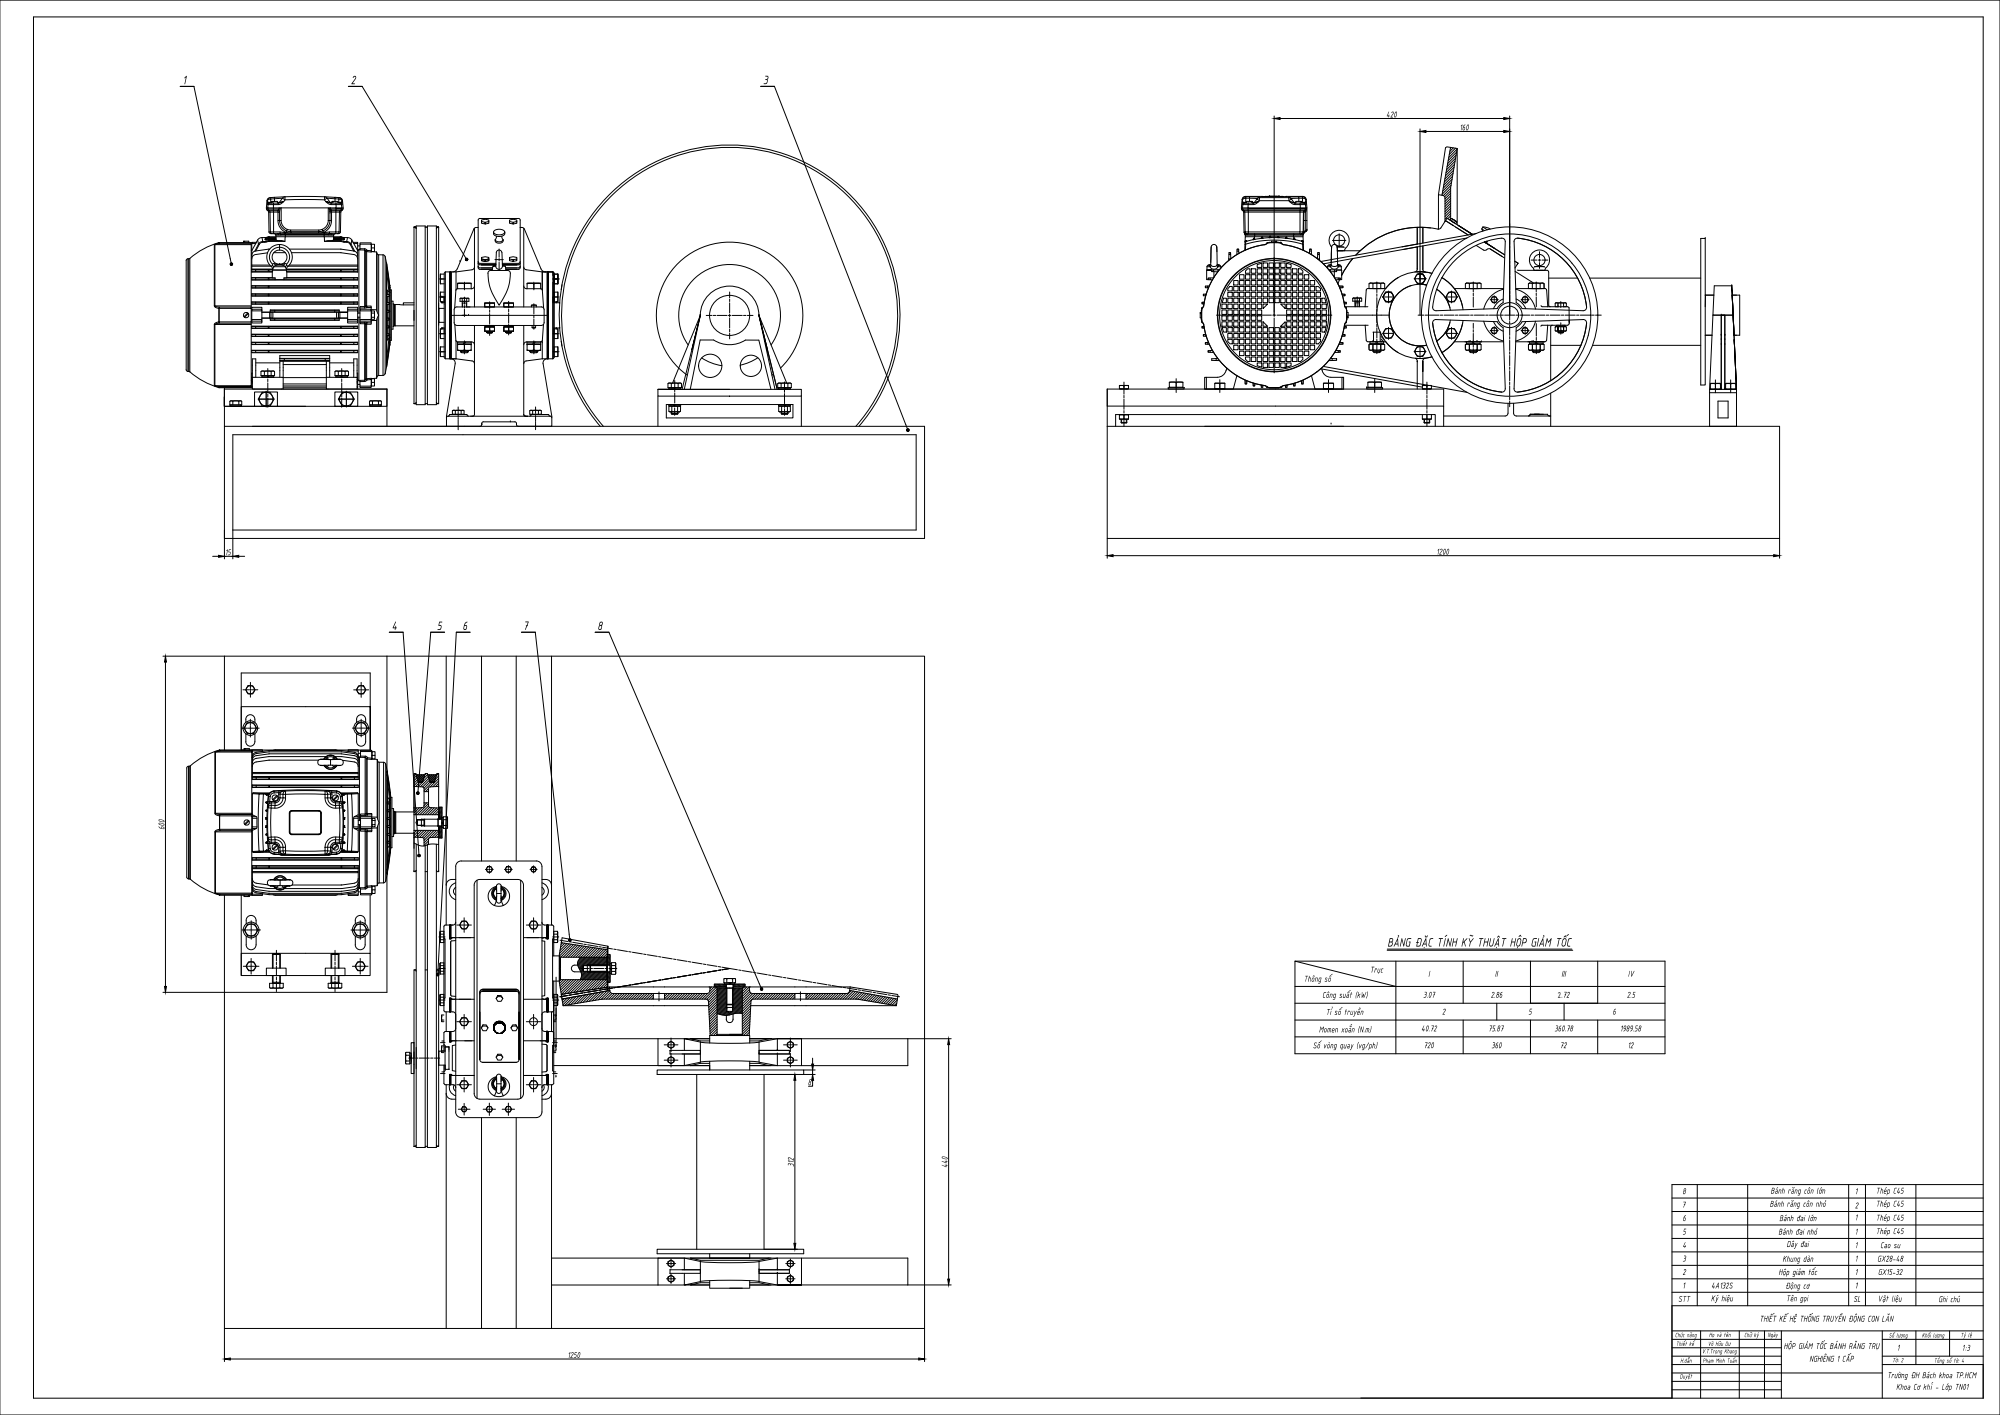
[picture p57: page 1]
Thép C45 4A132S 4 1; Thép C45 15; Số vòng quay (vg/ph); 2.86 360 2 BẢNG ĐẶC TÍNH KỸ THUẬT HỘP GIẢM TỐCIII 2.72 72; 1989.58 12 Momen xoắn (N.m)

600 Trục Thông số I II Công suất (kW)

Tỉ số truyền

STT | Ký hiệu | Tên gọi Dây đai | SL | Vật liệu 1 | Ghi chú 23156487 1:3 THIẾT KẾ HỆ THỐNG TRUYỀN ĐỘNG CON LĂN HỘP GIẢM TỐC BÁNH RĂNG TRỤ

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

Hộp giảm tốc | 11 | GX15-32 Khung dàn

Động cơ

Thiết kế | | | | | Số lượng | Khối lượng Tổng số tờ: 4 | Tỷ lệ Tờ: 2
Chức năng | Họ và tên | Chữ ký | Ngày | NGHIÊNG 1 CẤP

Phạm Minh Tuấn Võ Hữu Dư V.T.Trọng Khang

H.dẫn

Trường ĐH Bách khoa TP.HCM
Khoa Cơ khí - Lớp TN01
