duvohuu/Transmission_System_Project/Drawing/Detail1_1.pdf

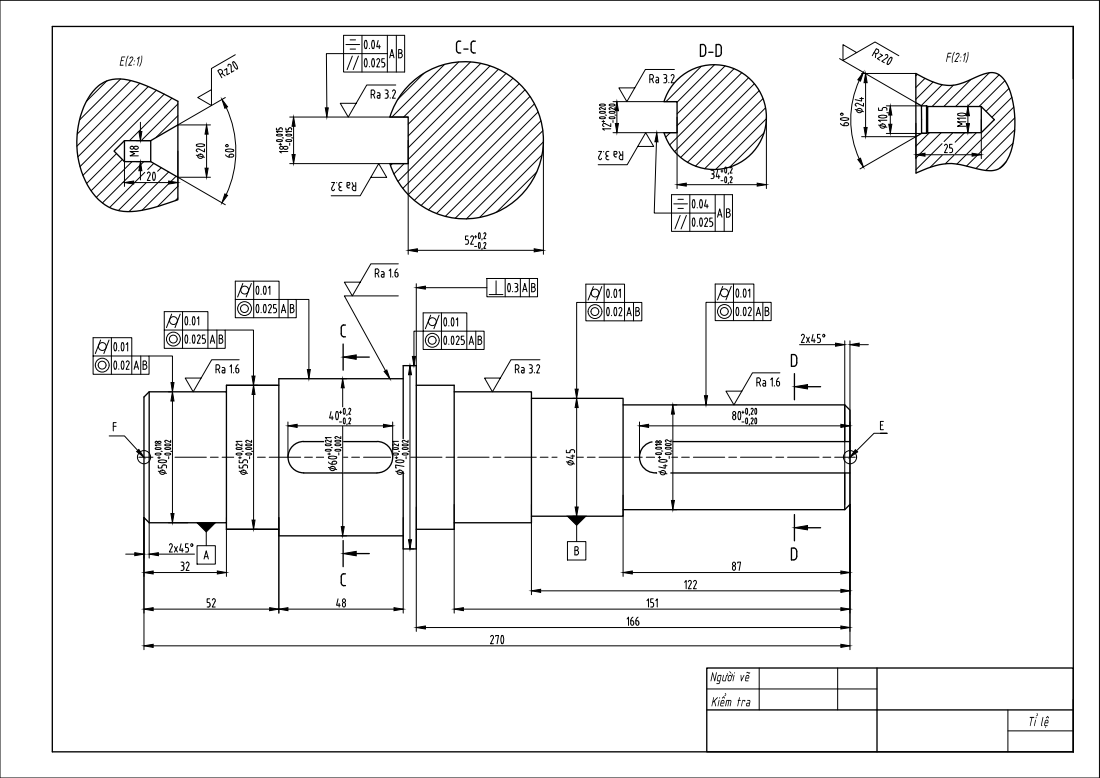
[picture p58: page 1]

Người vẽ
Kiểm tra
