duvohuu/Transmission_System_Project/Drawing/Detail2_1.pdf

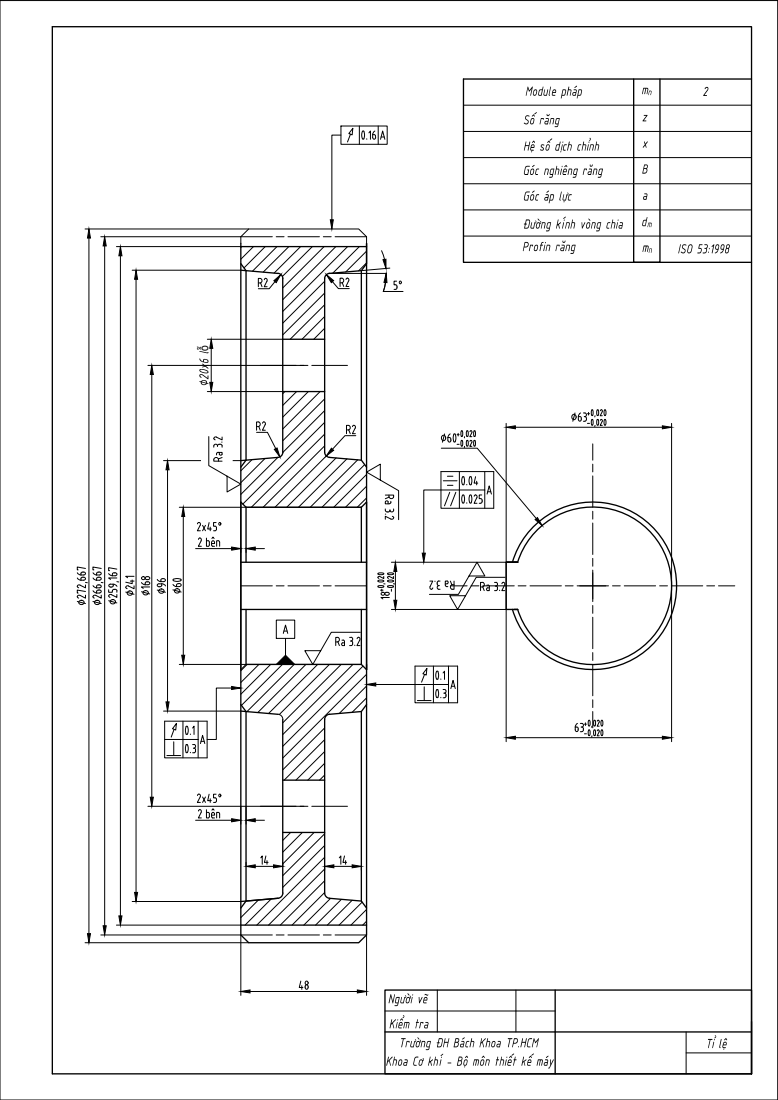
[picture p59: page 1]
Profin răng; ISO 53:1998 ∅20x6 l

Module pháp | mn | 2

Số răng | z

Hệ số dịch chỉnh | x

Góc nghiêng răng | B

Góc áp lực | a

Đường kính vòng chia | dm

Người vẽ
Kiểm tra
Trường ĐH Bách Khoa TP.HCM Khoa Cơ khí - Bộ môn thiết kế máy | Tỉ lệ
