duvohuu/Transmission_System_Project/Drawing/GearBox_1.pdf

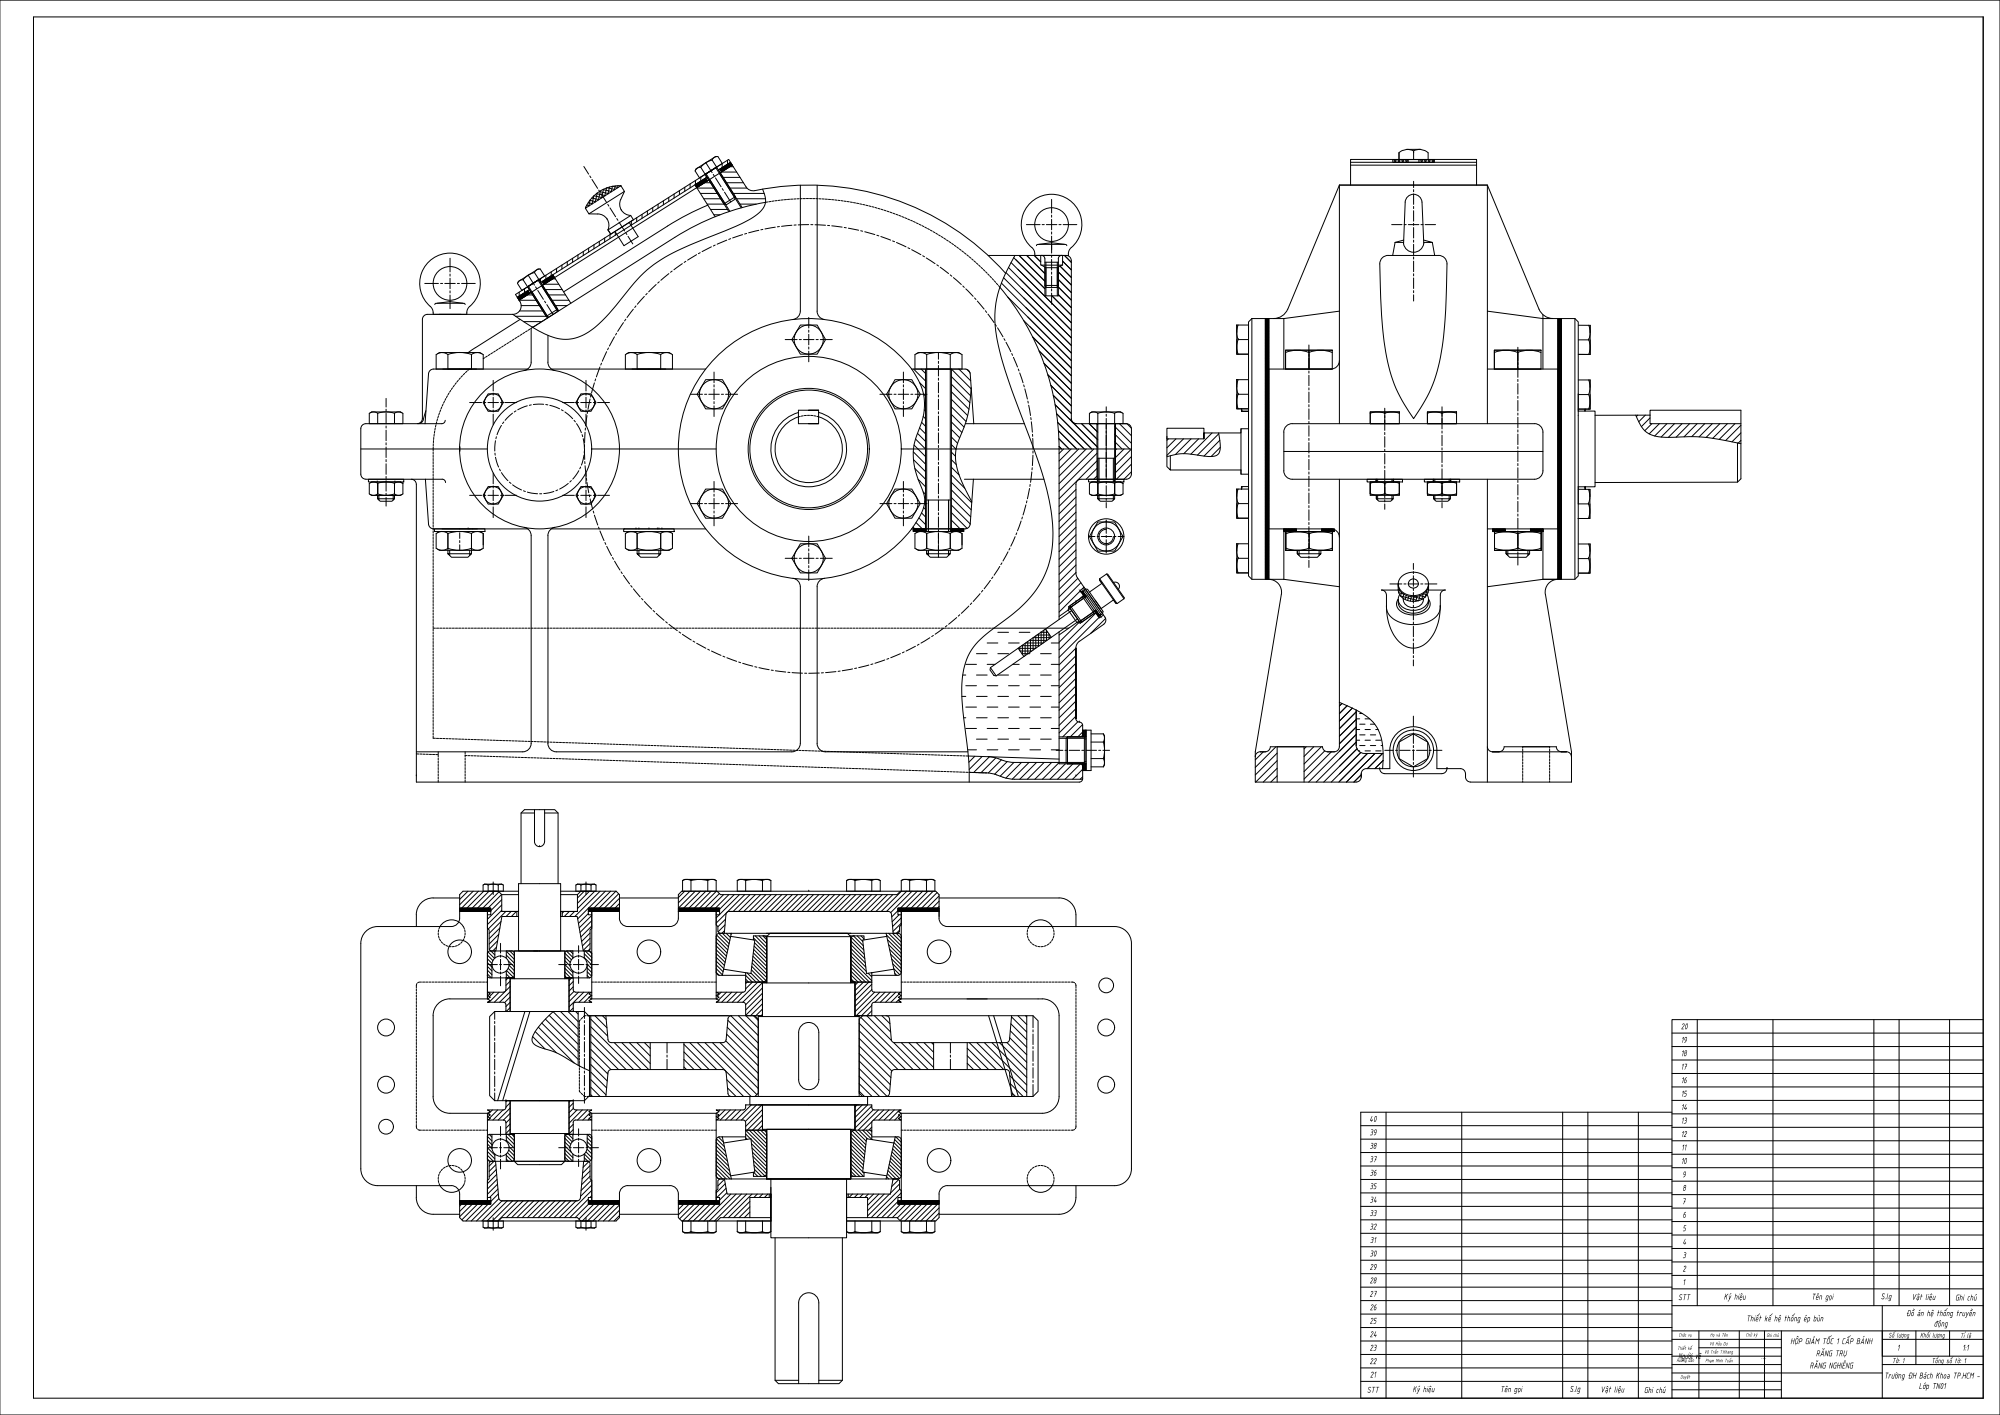
[picture p60: page 1]
STT1234567891011121314151617181920; Thiết kế hệ thống ép bùn; Đồ án hệ thống truyền động; Lớp TN01; Hướng dẫn; Ký hiệu; Tên gọi; Vật liệu; Ghi chú STT21 22232425262728293031 323334353637383940; Ghi chú; Người vẽ

Thiết kế | Võ Trần T.Khang Võ Hữu Dư Họ và Tên | | | | Số lượng | Khối lượng Tổng số tờ: 1 | Tỉ lệ 1 1:1 Tờ: 1
Chức vụ | | Chữ ký | Ghi chú | HỘP GIẢM TỐC 1 CẤP BÁNH RĂNG TRỤ RĂNG NGHIÊNG

Phạm Minh Tuấn

Trường ĐH Bách Khoa TP.HCM -
