duvohuu/Transmission_System_Project/Drawing/GearBox_2.pdf

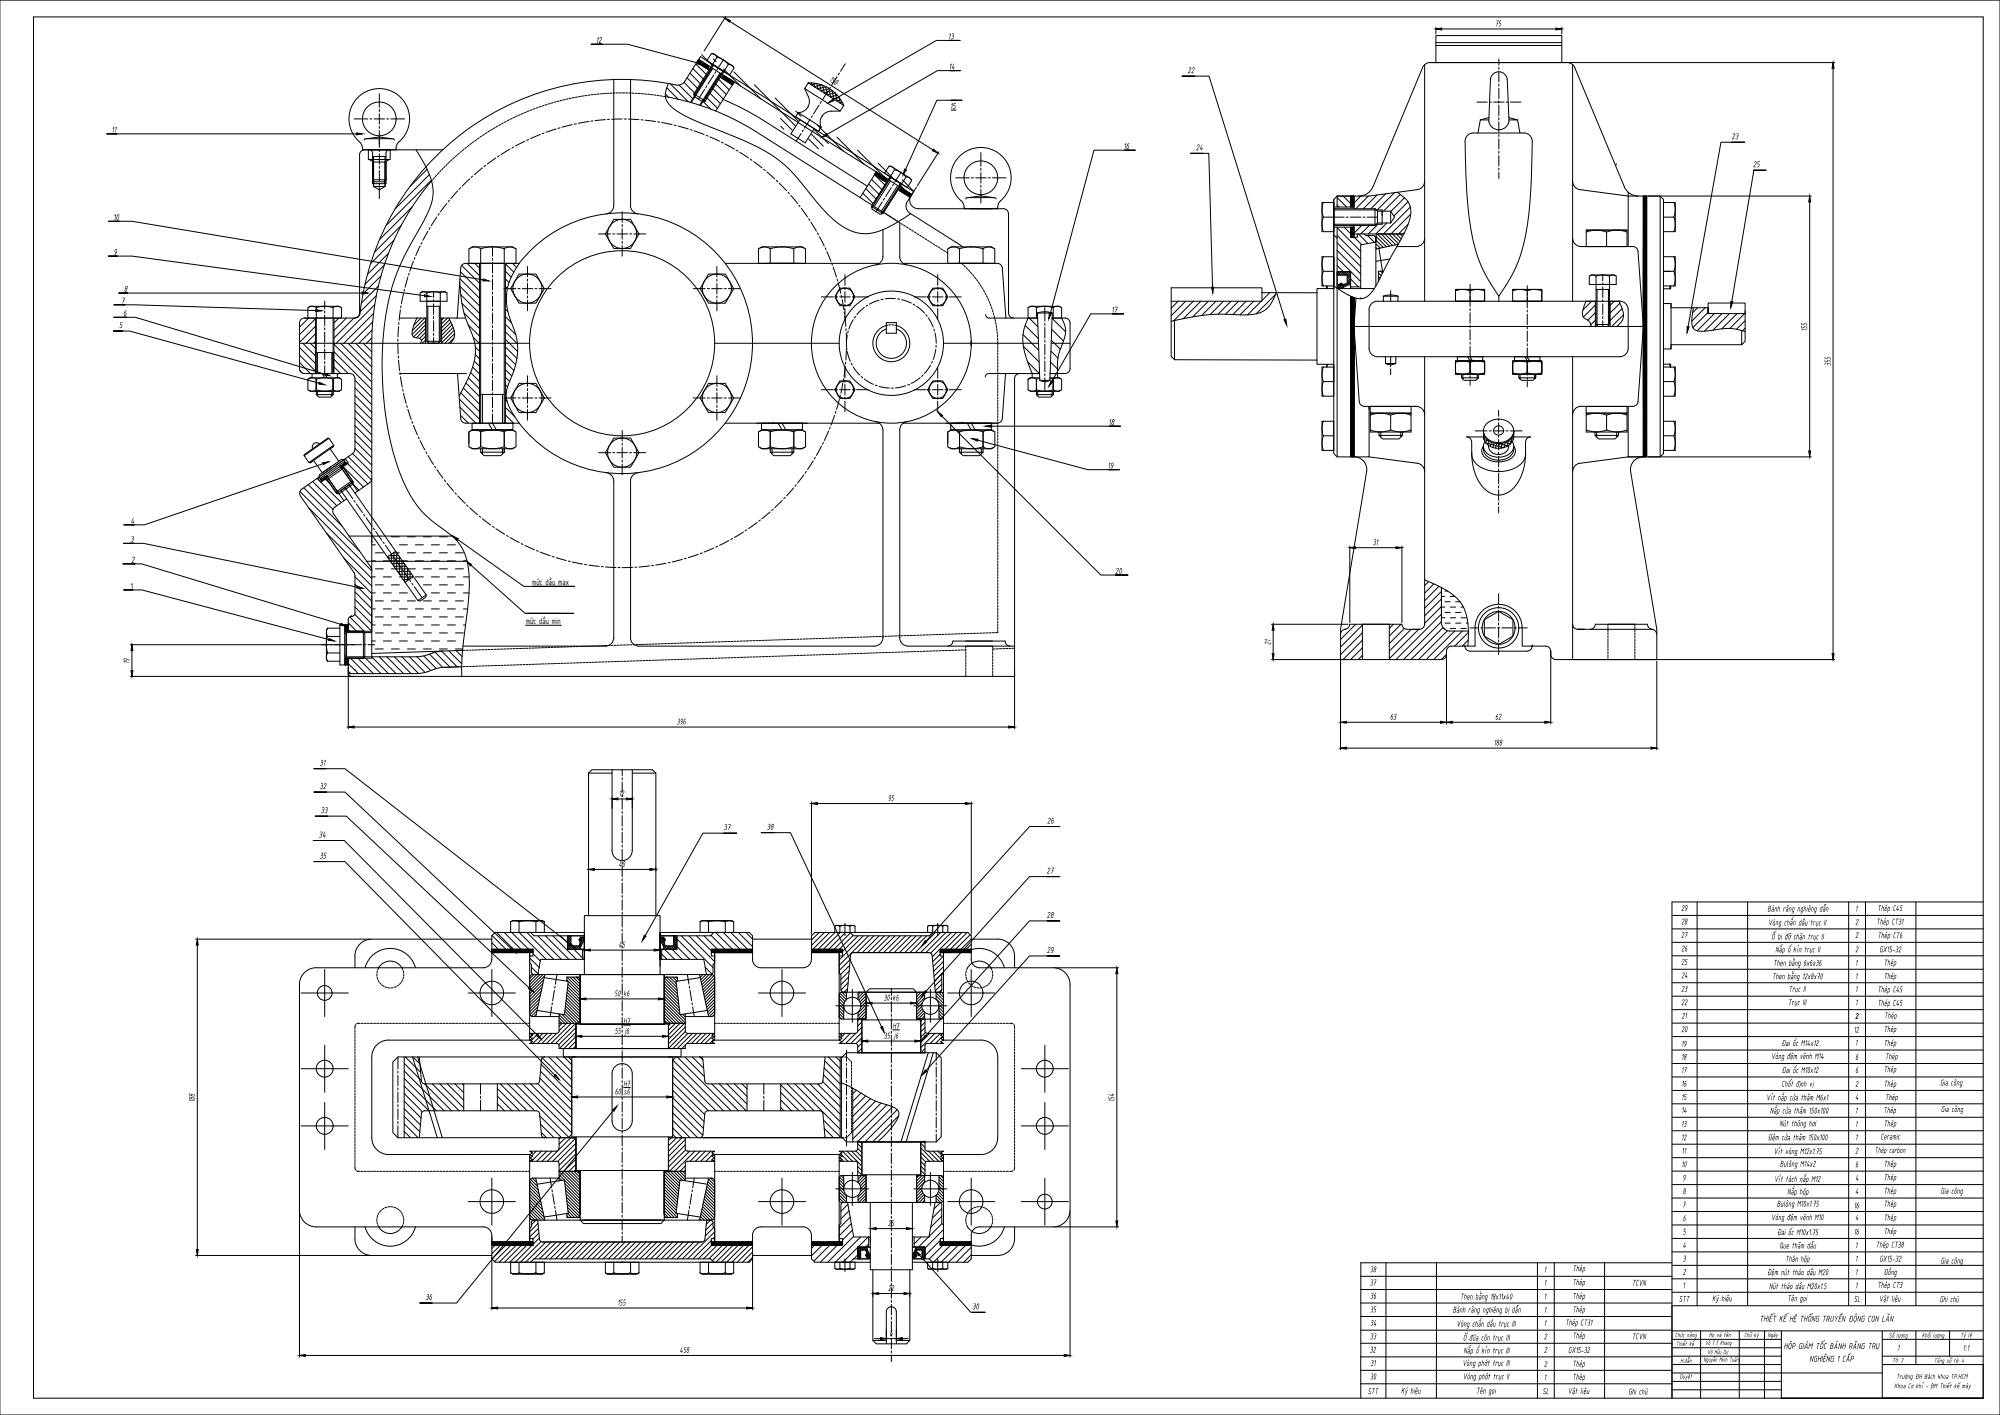
[picture p61: page 1]
STT; Ký hiệu; Tên gọi; Vật liệu; Ghi chú; 716152021 172324222627252928 STT; 1:1 THIẾT KẾ HỆ THỐNG TRUYỀN ĐỘNG CON LĂN HỘP GIẢM TỐC BÁNH RĂNG TRỤ; NGHIÊNG 1 CẤP; Chức năng 14; Trường ĐH Bách khoa TP.HCM; Họ và tên; Chữ ký; Ngày; Thiết kế; Số lượng; Khối lượng; Tổng số tờ: 4; Nút tháo dầu M20x1.5; Thép CT3 Đồng; GX15-32 Đai ốc M10x1.75; 1 Vòng đệm vênh M10; Thép CT38 Thép; Nắp hộp; Thép; Thép carbon; Thép C45; Thép Thép CT31; Thép 12; Thép 32; Thép 3334353637; Thép CT31; Thép 3031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

mức dầu min

Bánh răng nghiêng dẫn
Vòng chắn dầu trục II
Nắp ổ kín trục II
Then bằng 6x6x36
Then bằng 12x8x70
6 Que thăm dầu

Vòng đệm vênh M14

Chốt định vị
Vít nắp cửa thăm M6x1
1 Bulông M14x2
Nút thông hơi
Đệm cửa thăm 150x100
6 Vít vòng M12x1.75

Vít tách nắp M12
Bulông M10x1.75

Thân hộp
Đệm nút tháo dầu M20

Then bằng 18x11x40
Bánh răng nghiêng bị dẫn
Vòng chắn dầu trục III
Ổ đũa côn trục III
Nắp ổ kín trục III
Vòng phớt trục III
Vòng phớt trục II

Khoa Cơ khí - BM Thiết kế máy
