duvohuu/Transmission_System_Project/(commit log)

2025-05-07 Creat project
    [+f-n+·+²+¼+¿-ú.iam, +f-n+·+²+¼+¿-ú.ipt, +f-n+·+²+¼+¿-ú_1.ipt, +f-n+·+²+¼+¿-ú_10.ipt, +f-n+·+²+¼+¿-ú_11.ipt, +f-n+·+²+¼+¿-ú_12.ipt, +f-n+·+²+¼+¿-ú_13.ipt, +f-n+·+²+¼+¿-ú_14.ipt]
2025-05-07 Update cad and report
    [Detail_1.dwg, Detail_2.dwg, GearBox.dwg, System.dwg]
2025-06-01 modify cad
    [Detail_1.dwg, Detail_2.dwg, GearBox.dwg, System.dwg]
